jpwolfe9912/BareDrones-FC-V1/PNGs/3D Front.png

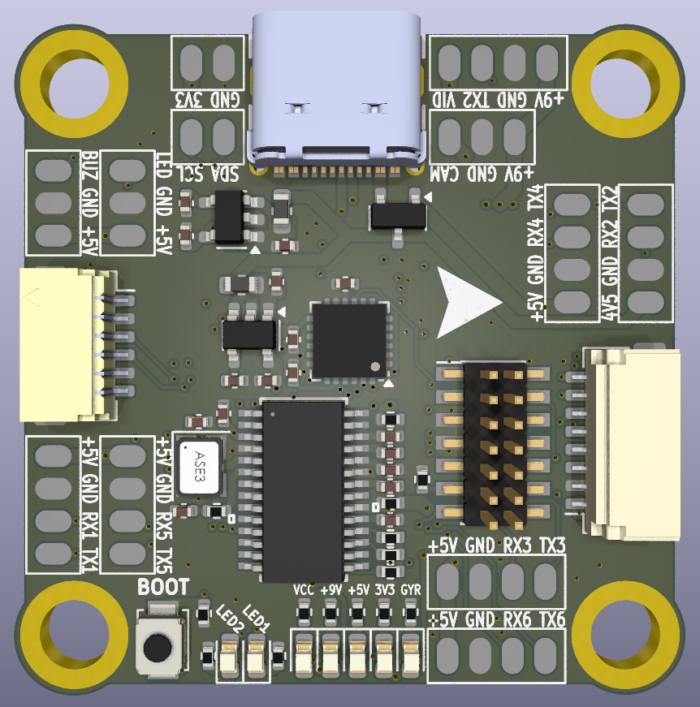
PNGs/3D Front.png
