jpwolfe9912/BareDrones-FC-V1/PNGs/3D Back.png

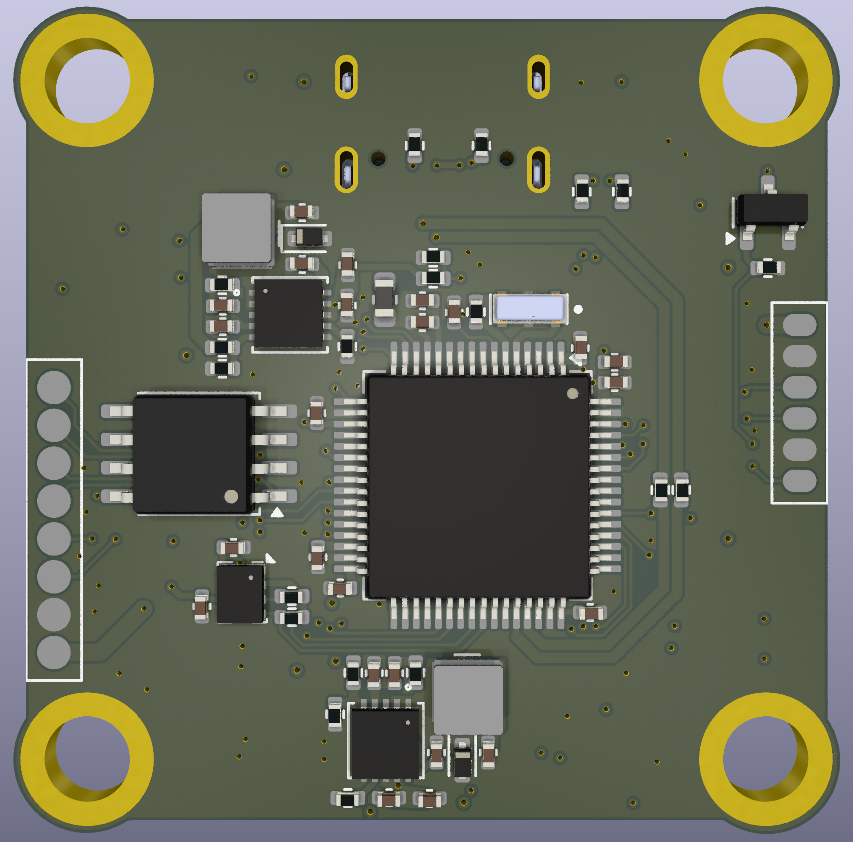
PNGs/3D Back.png
