jpwolfe9912/BareDrones-FC-V1/PNGs/Cu Pics/Back Cu.png

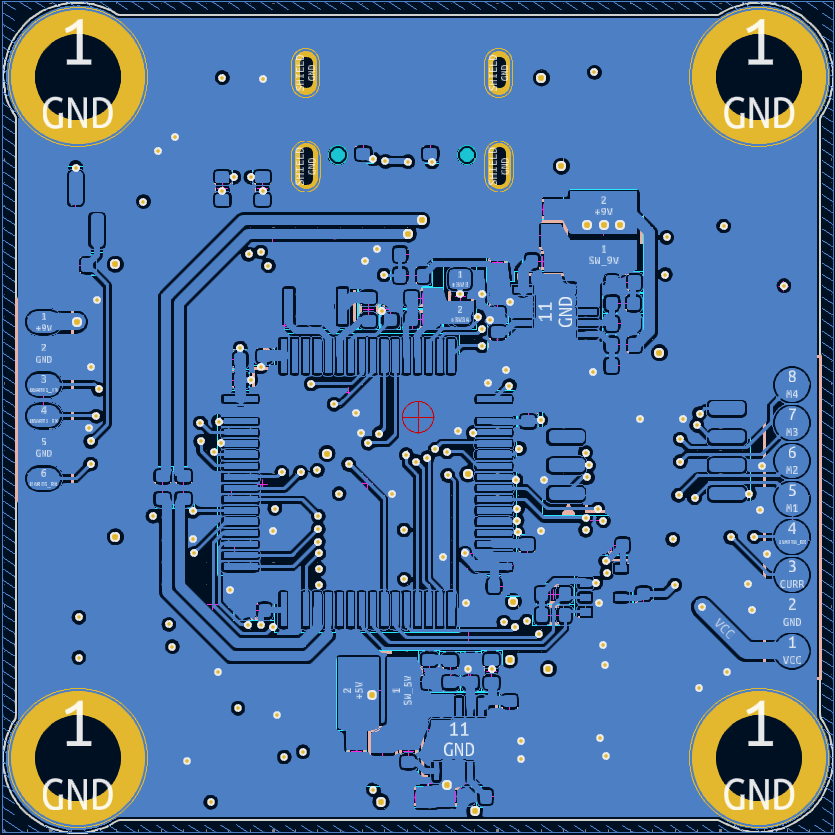
PNGs/Cu Pics/Back Cu.png
