jpwolfe9912/BareDrones-FC-V1/PNGs/Cu Pics/Front Cu.png

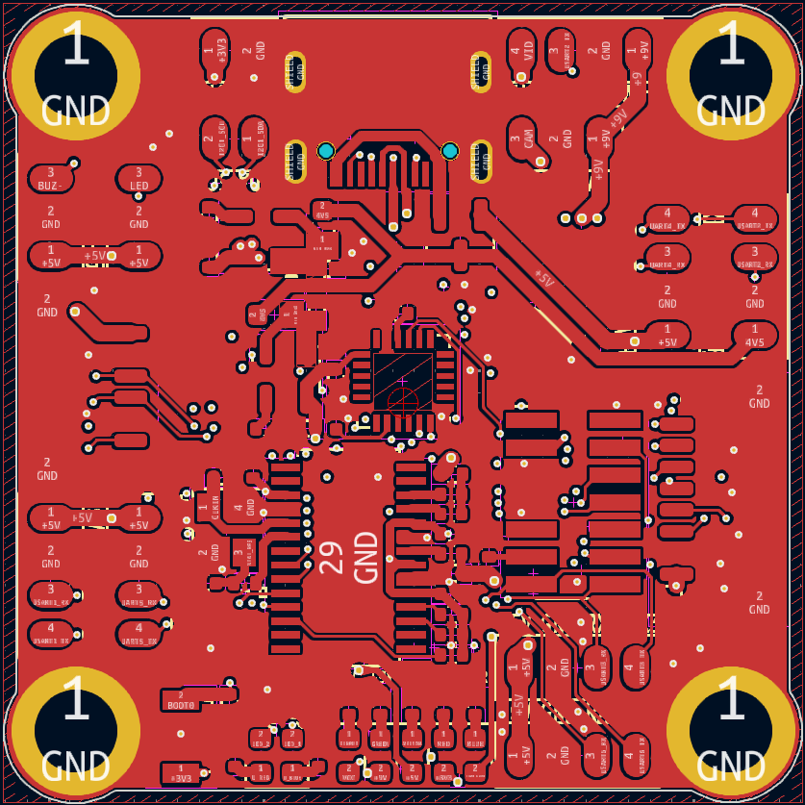
PNGs/Cu Pics/Front Cu.png
