jpwolfe9912/BareDrones-FC-V1/PNGs/Cu Pics/GND Cu.png

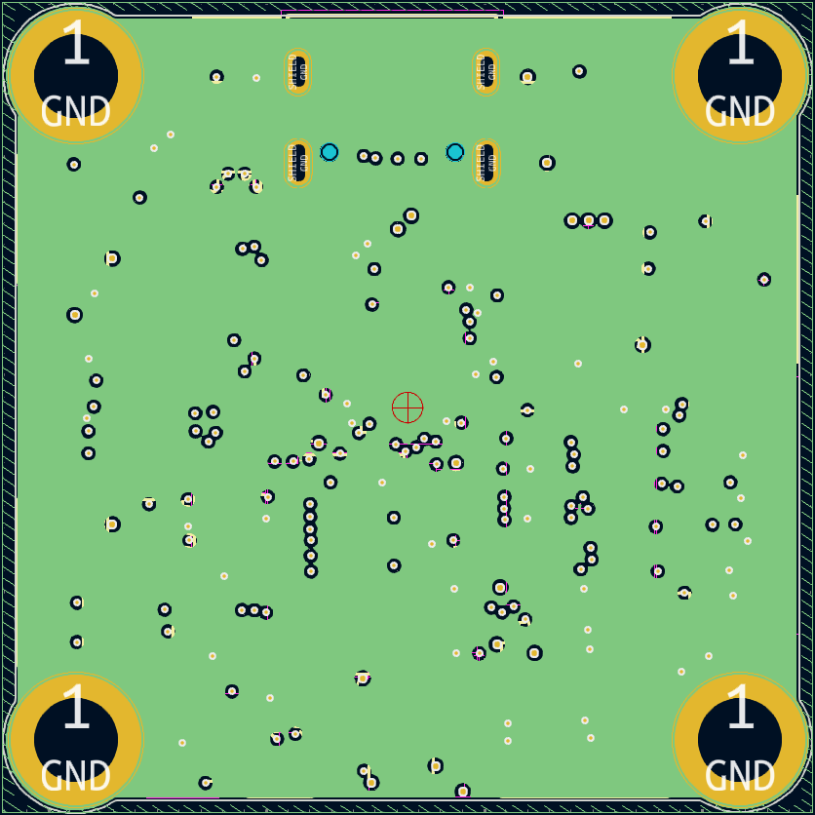
PNGs/Cu Pics/GND Cu.png
