jpwolfe9912/BareDrones-FC-V1/PNGs/Cu Pics/PWR Cu.png

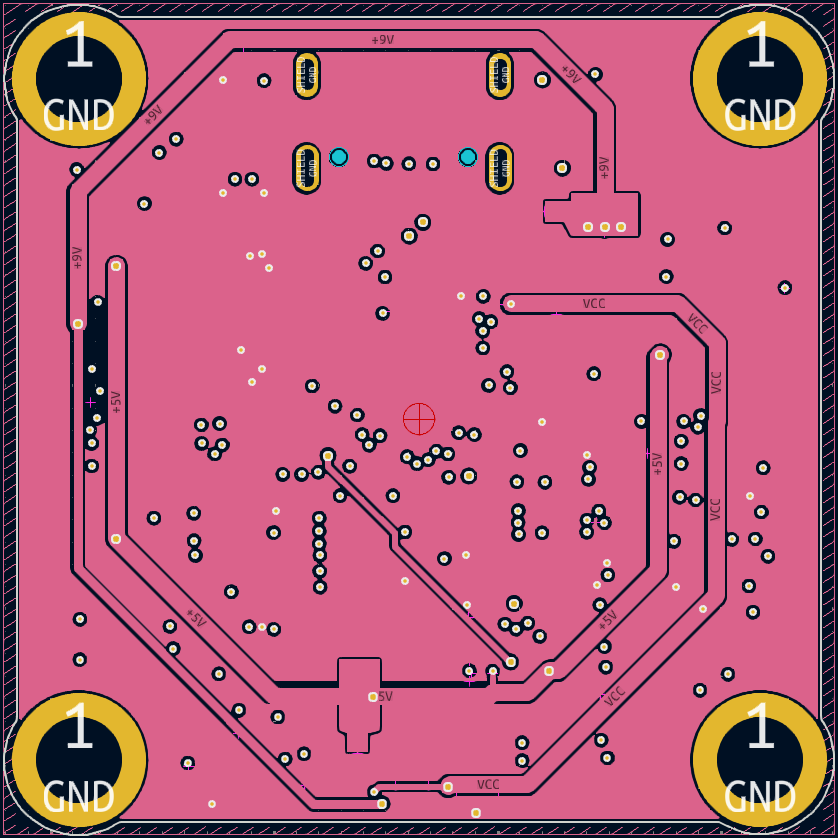
PNGs/Cu Pics/PWR Cu.png
