jpwolfe9912/BareDrones-FC-V1/PNGs/Cu Pics/Screenshot 2024-04-05 191036.png

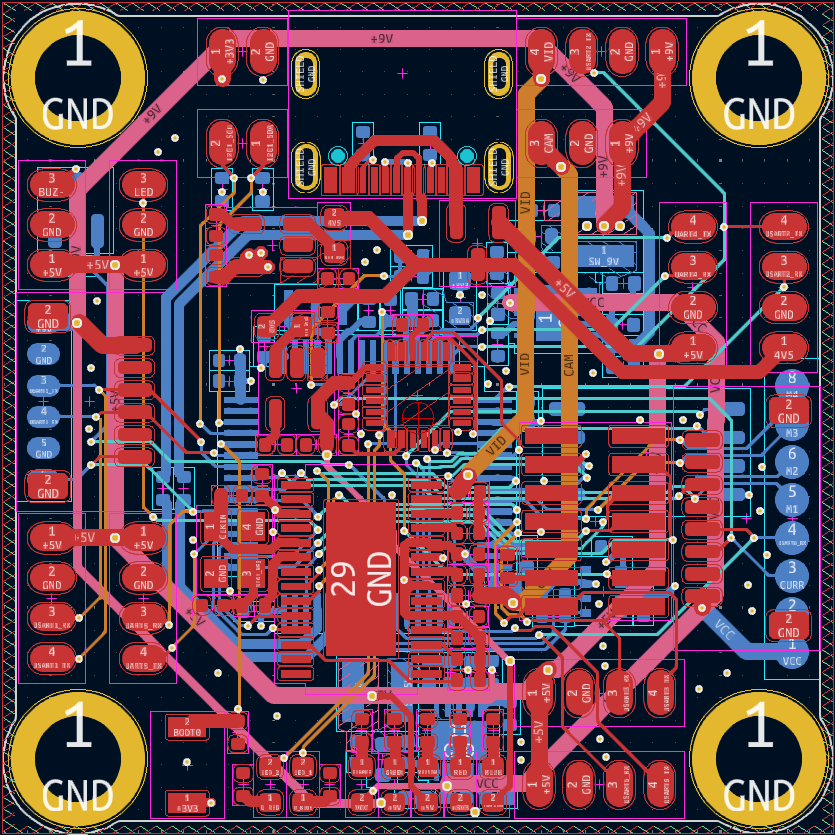
PNGs/Cu Pics/Screenshot 2024-04-05 191036.png
