jpwolfe9912/BareDrones-FC-V1/PNGs/Cu Pics/Signal 1 Cu.png

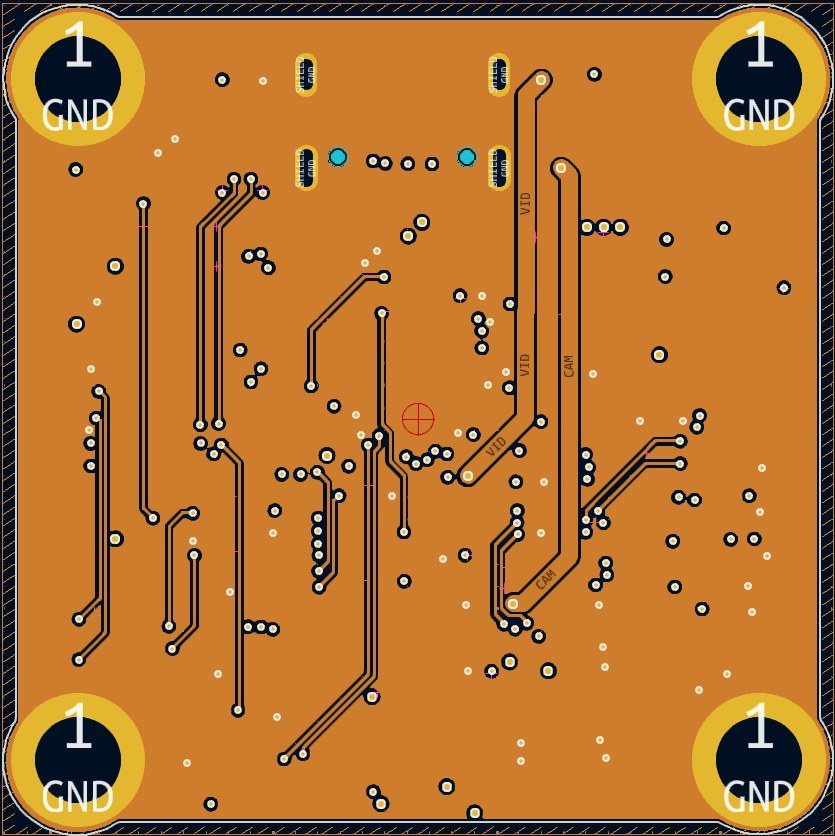
PNGs/Cu Pics/Signal 1 Cu.png
