jpwolfe9912/BareDrones-FC-V1/PNGs/Cu Pics/Signal 2 Cu.png

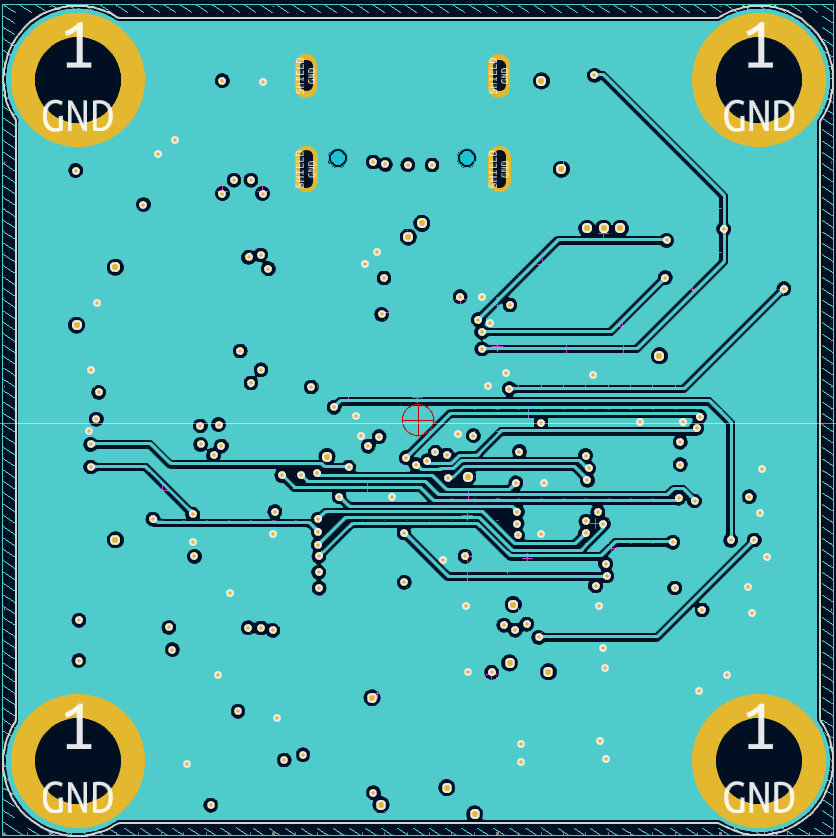
PNGs/Cu Pics/Signal 2 Cu.png
