jpwolfe9912/BareDrones-FC-V1/PNGs/Schematic.pdf

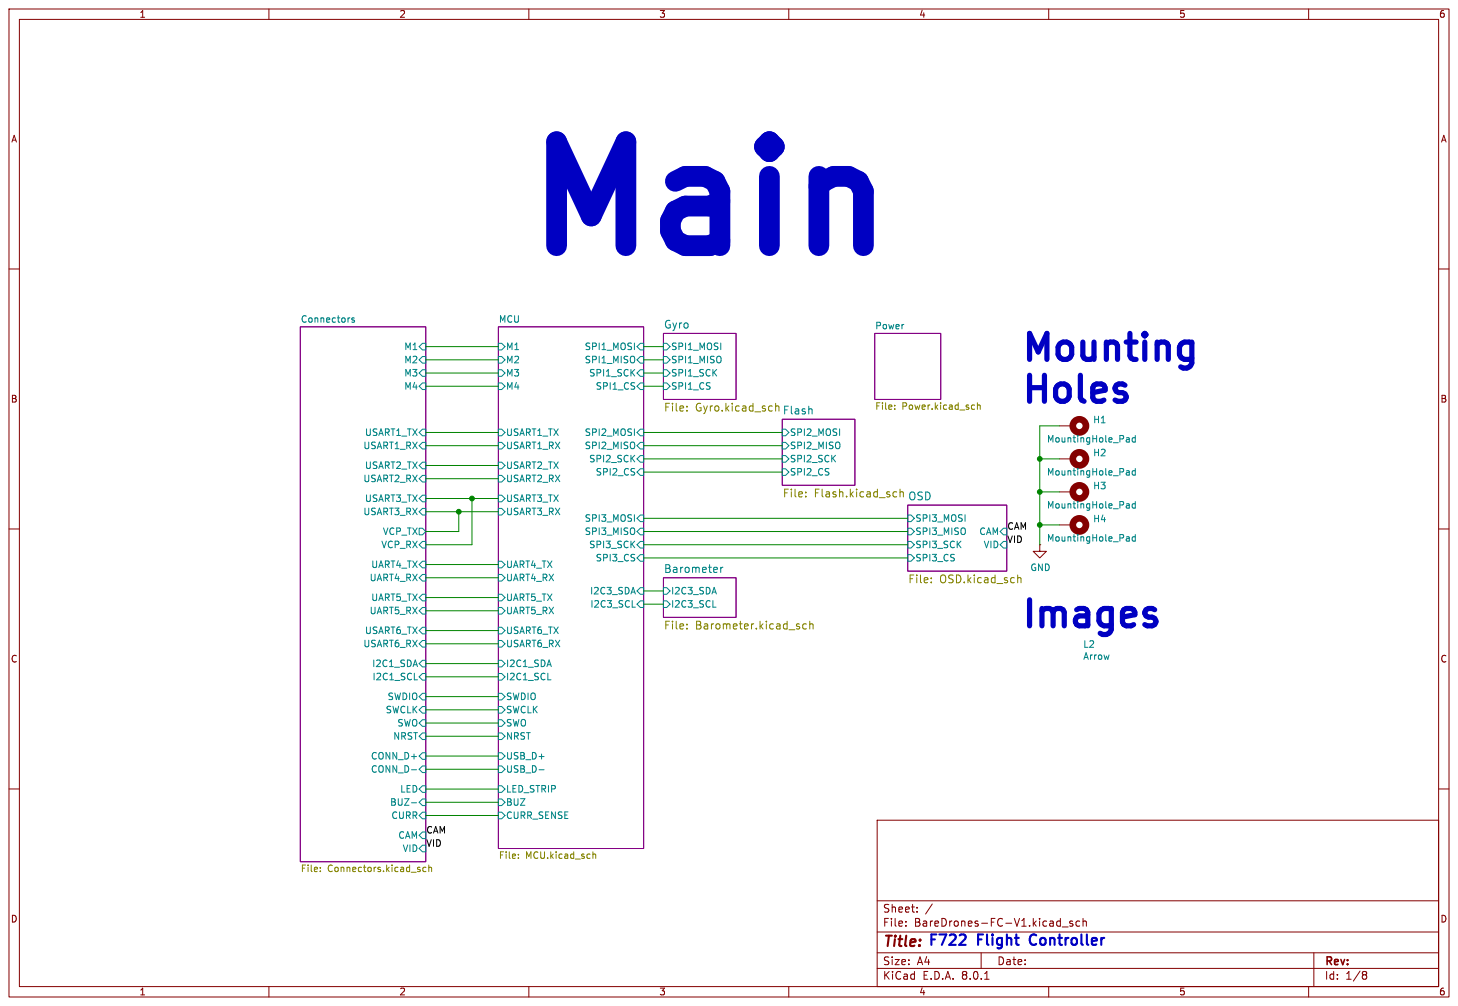
[picture p11: page 1]

SPI1_CS Gyro File: Gyro.kicad_sch
File: OSD.kicad_sch Power File: Power.kicad_sch SPI1_MOSI SPI1_MISO

Id: 1/8 Title: File: BareDrones-FC-V1.kicad_sch Sheet: /
F722 Flight Controller

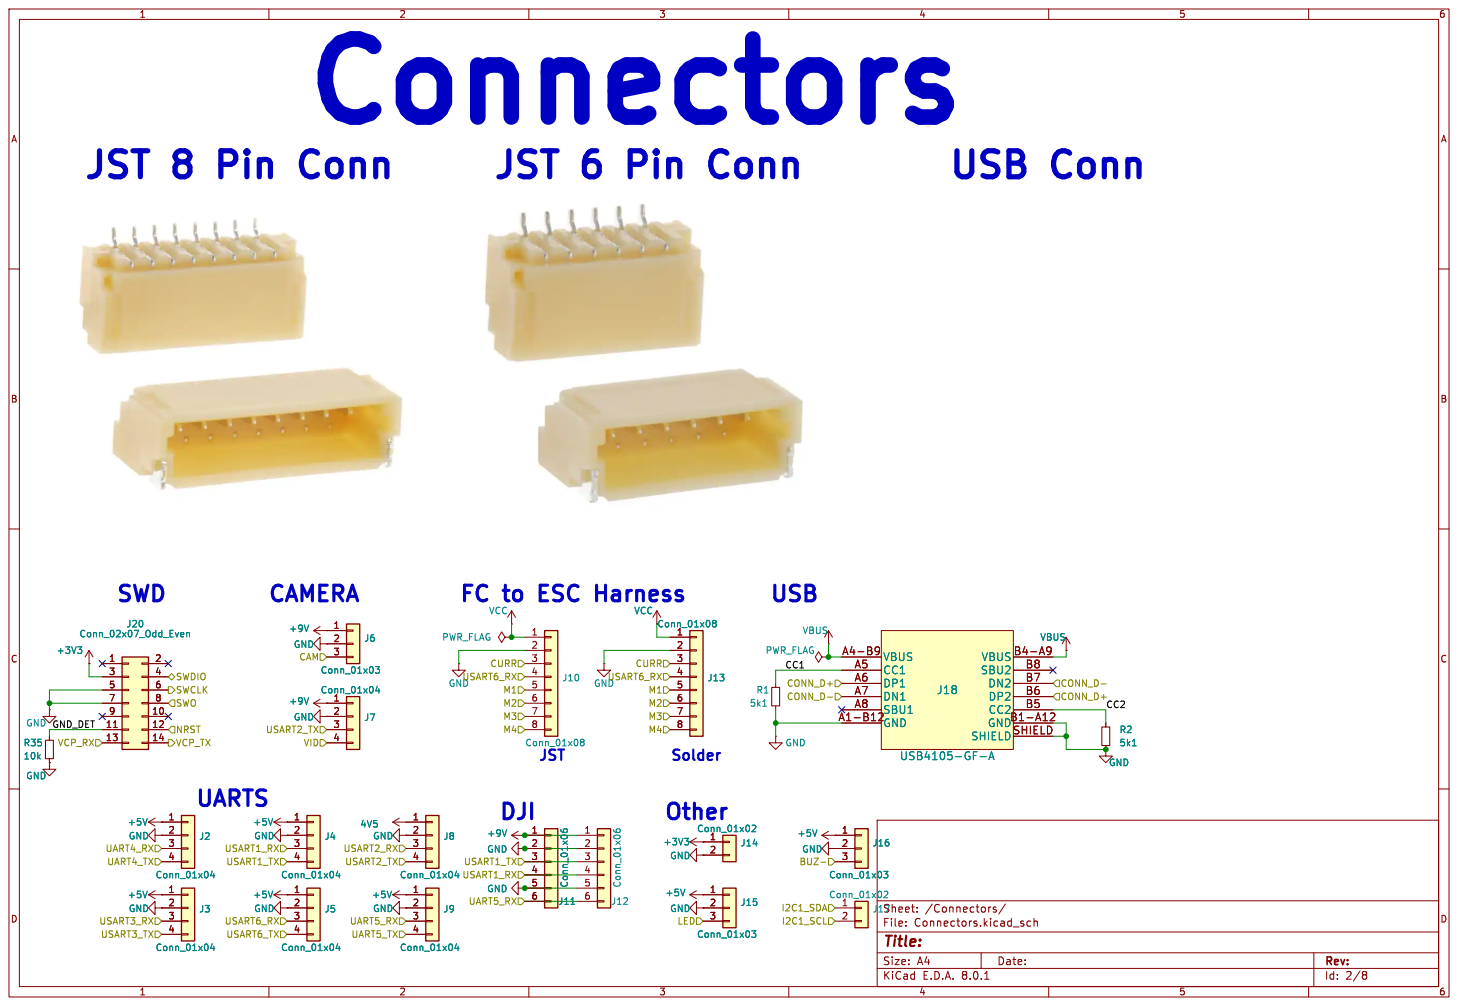
[picture p12: page 2]

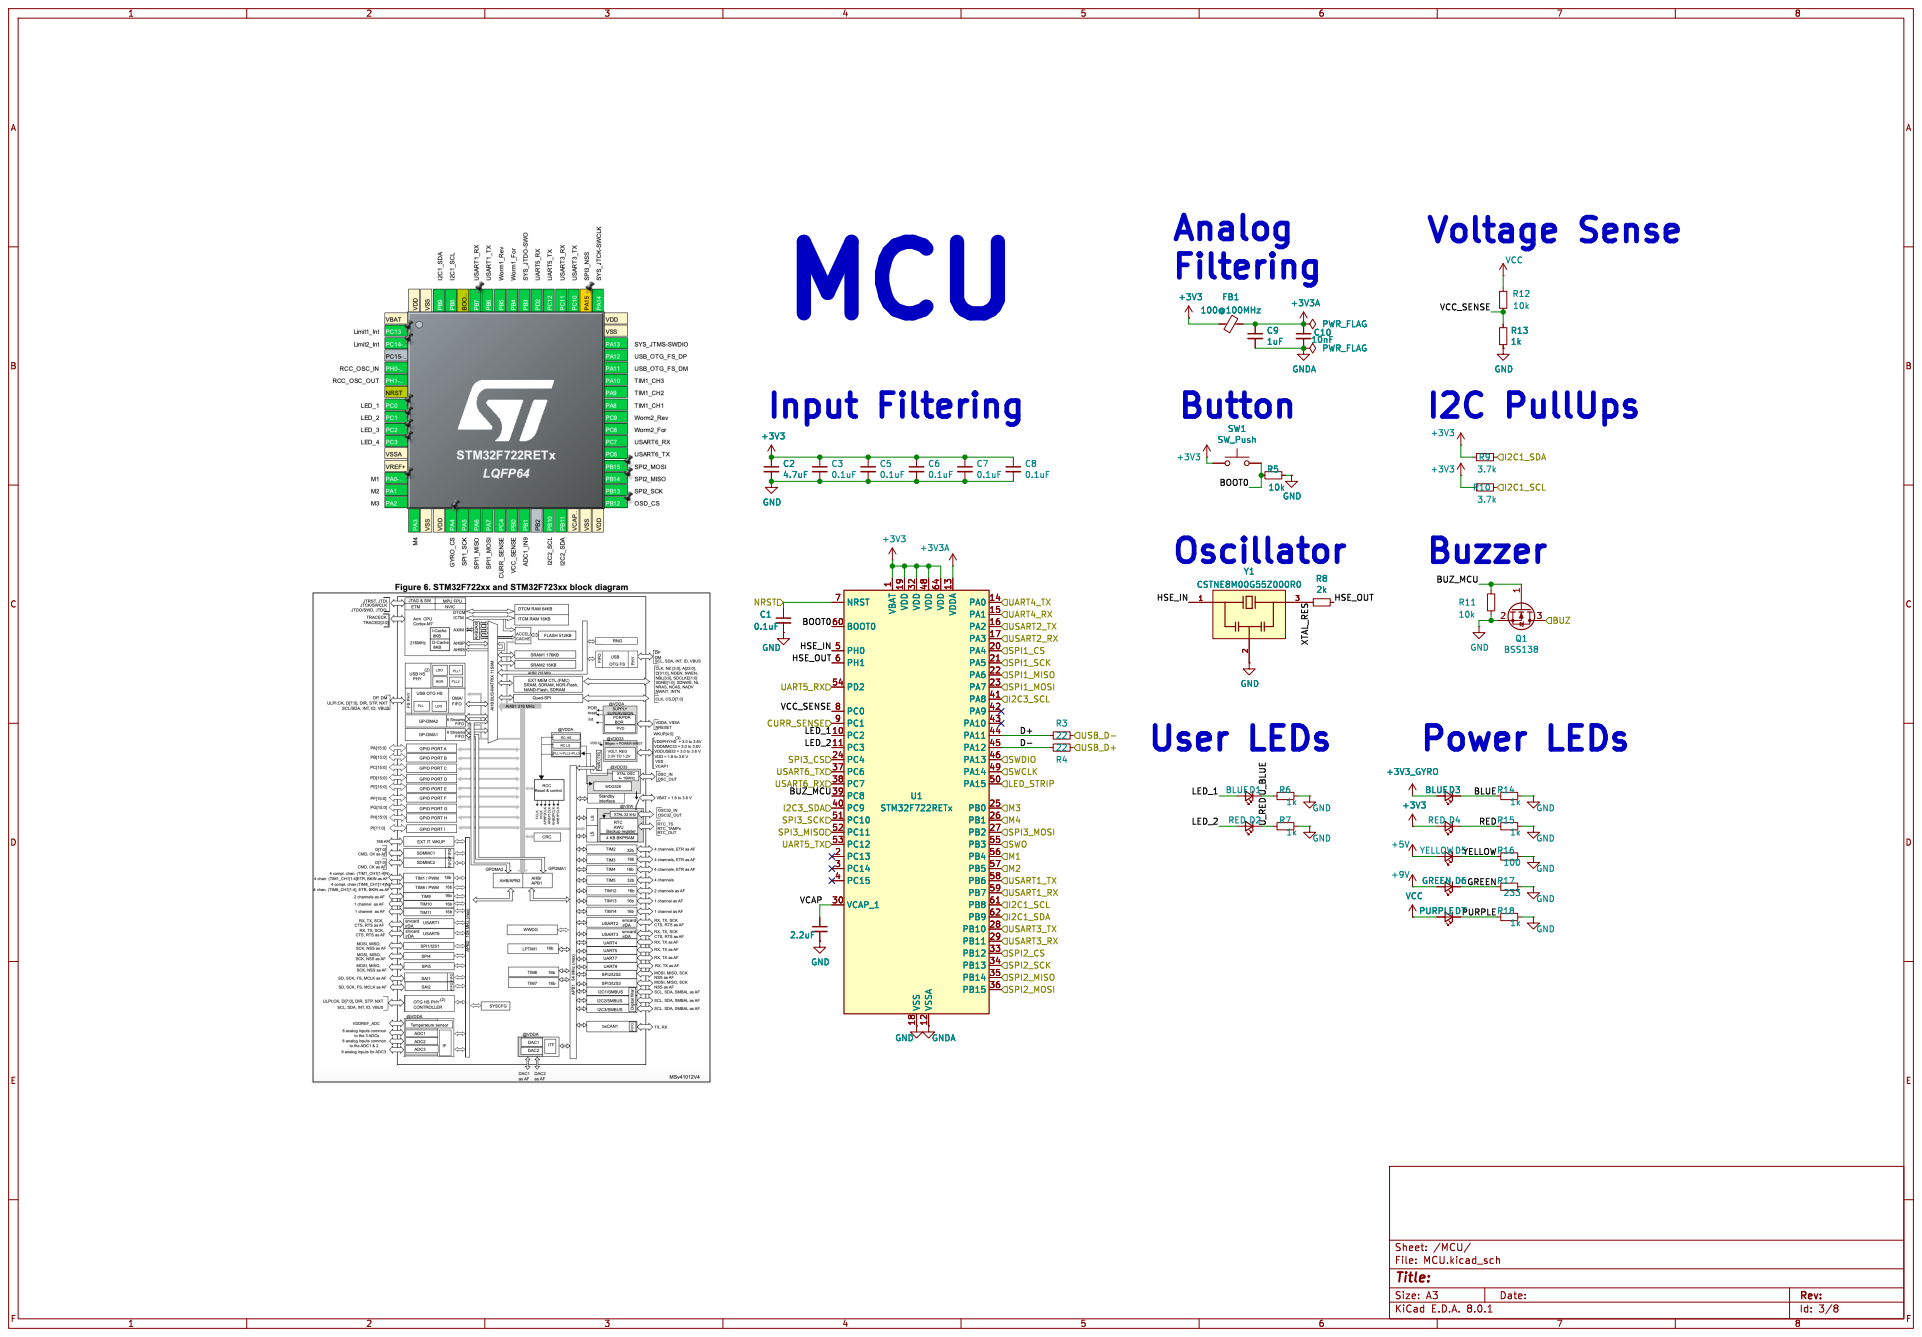
[picture p13: page 3]

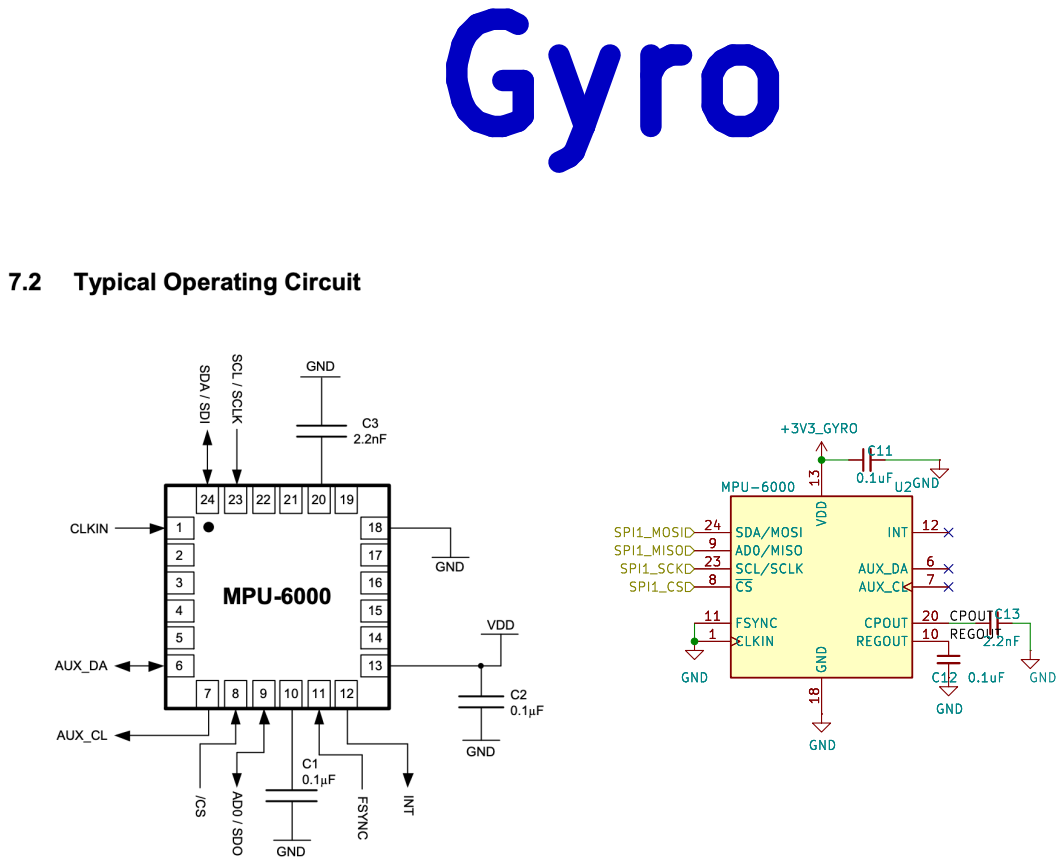
[picture p14: page 4]

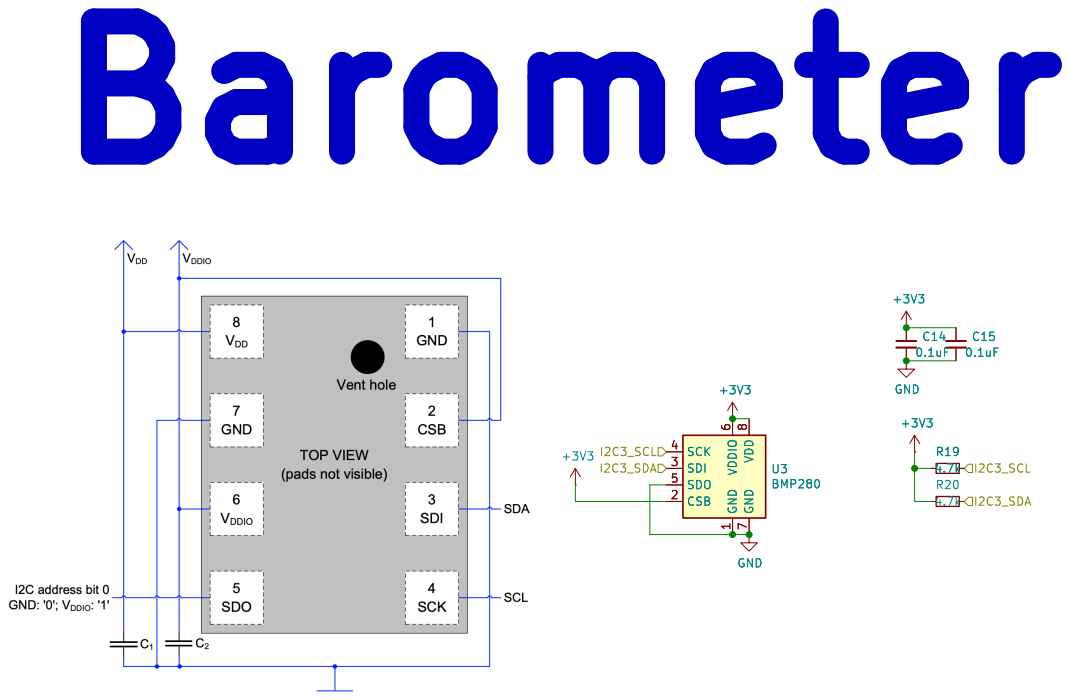
[picture p15: page 5]

1 CSB 2 SDI 3 SCK 4 SDO 5 VDDIO

Id: 5/8 Title: File: Barometer.kicad_sch Sheet: /Barometer/ GND

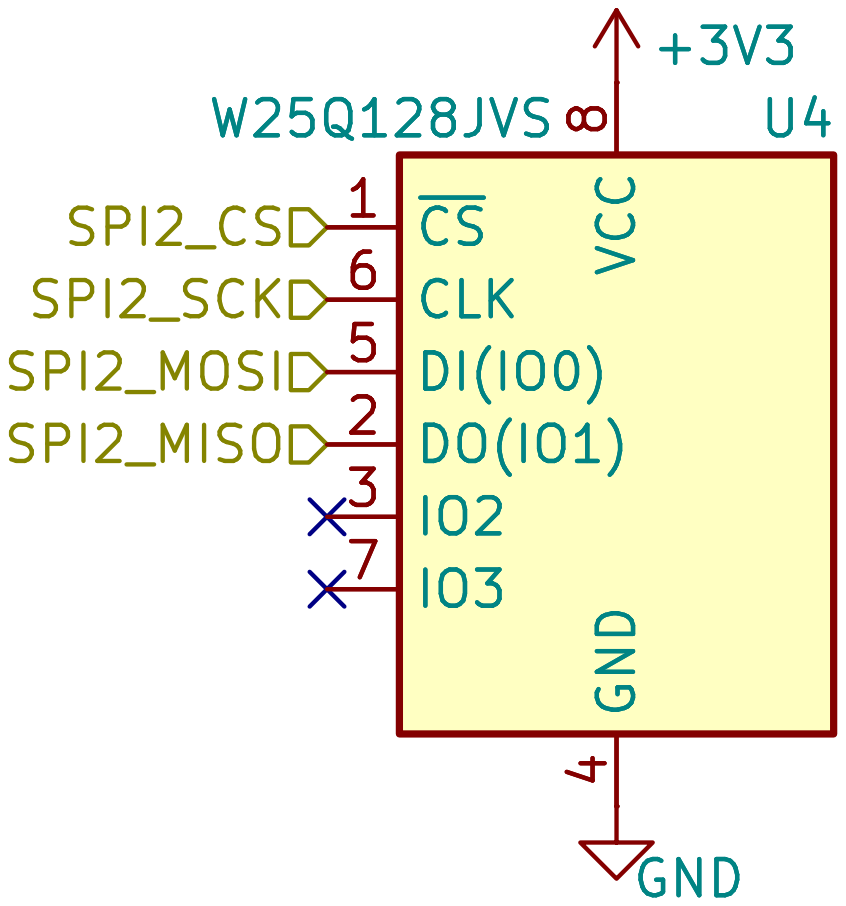
[picture p16: page 6]

Id: 6/8 Title: File: Flash.kicad_sch Sheet: /Flash/ GND

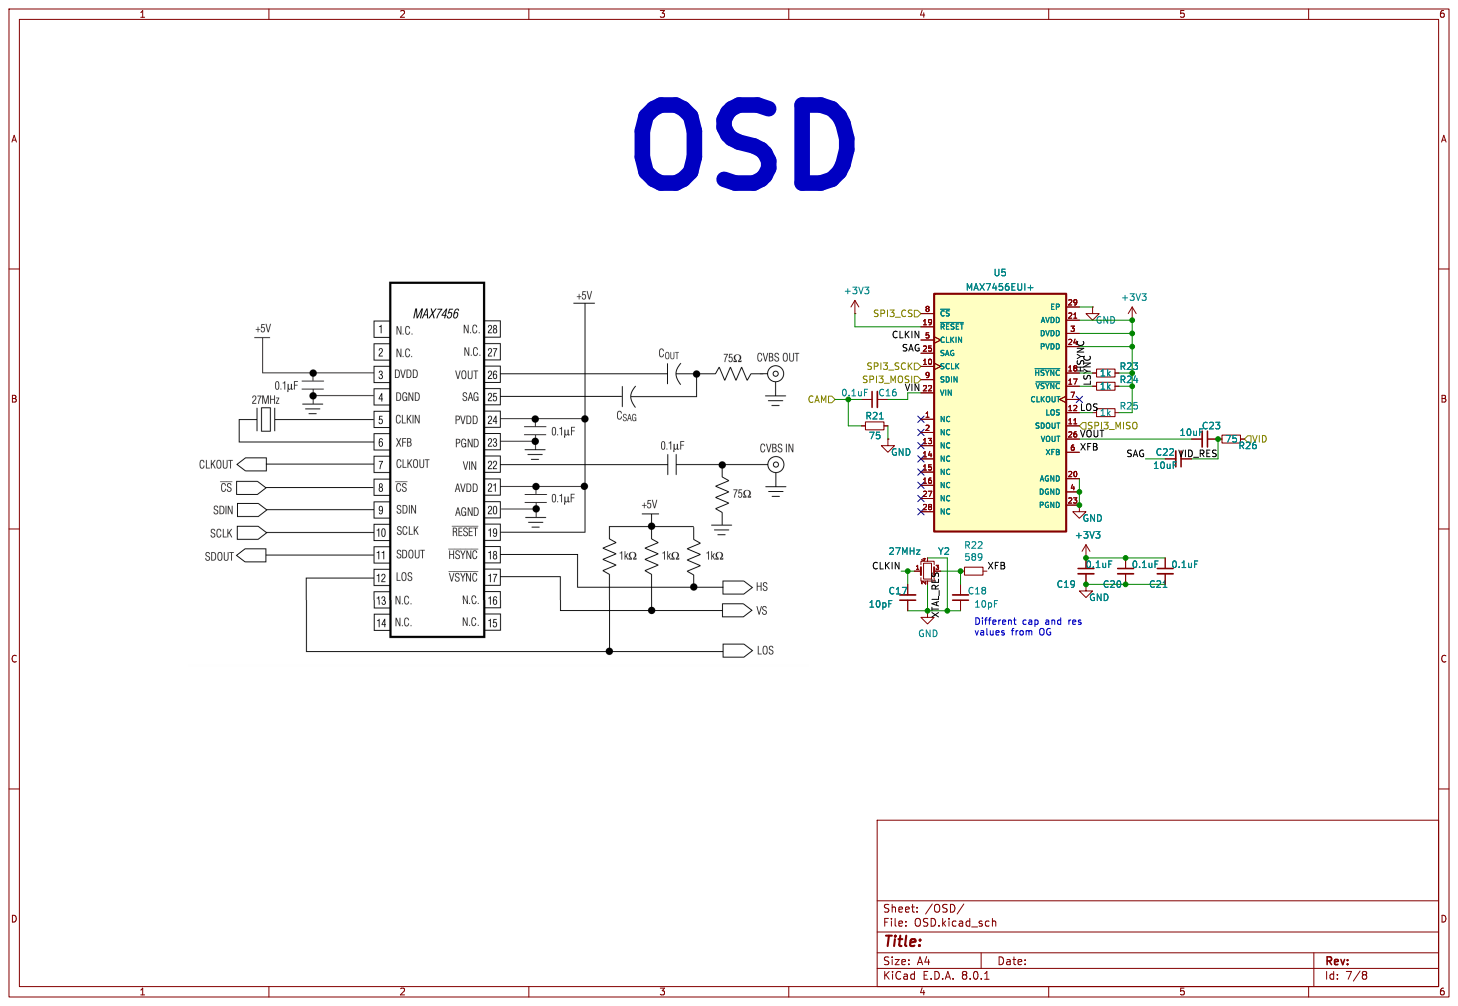
[picture p17: page 7]

values from OG OSD

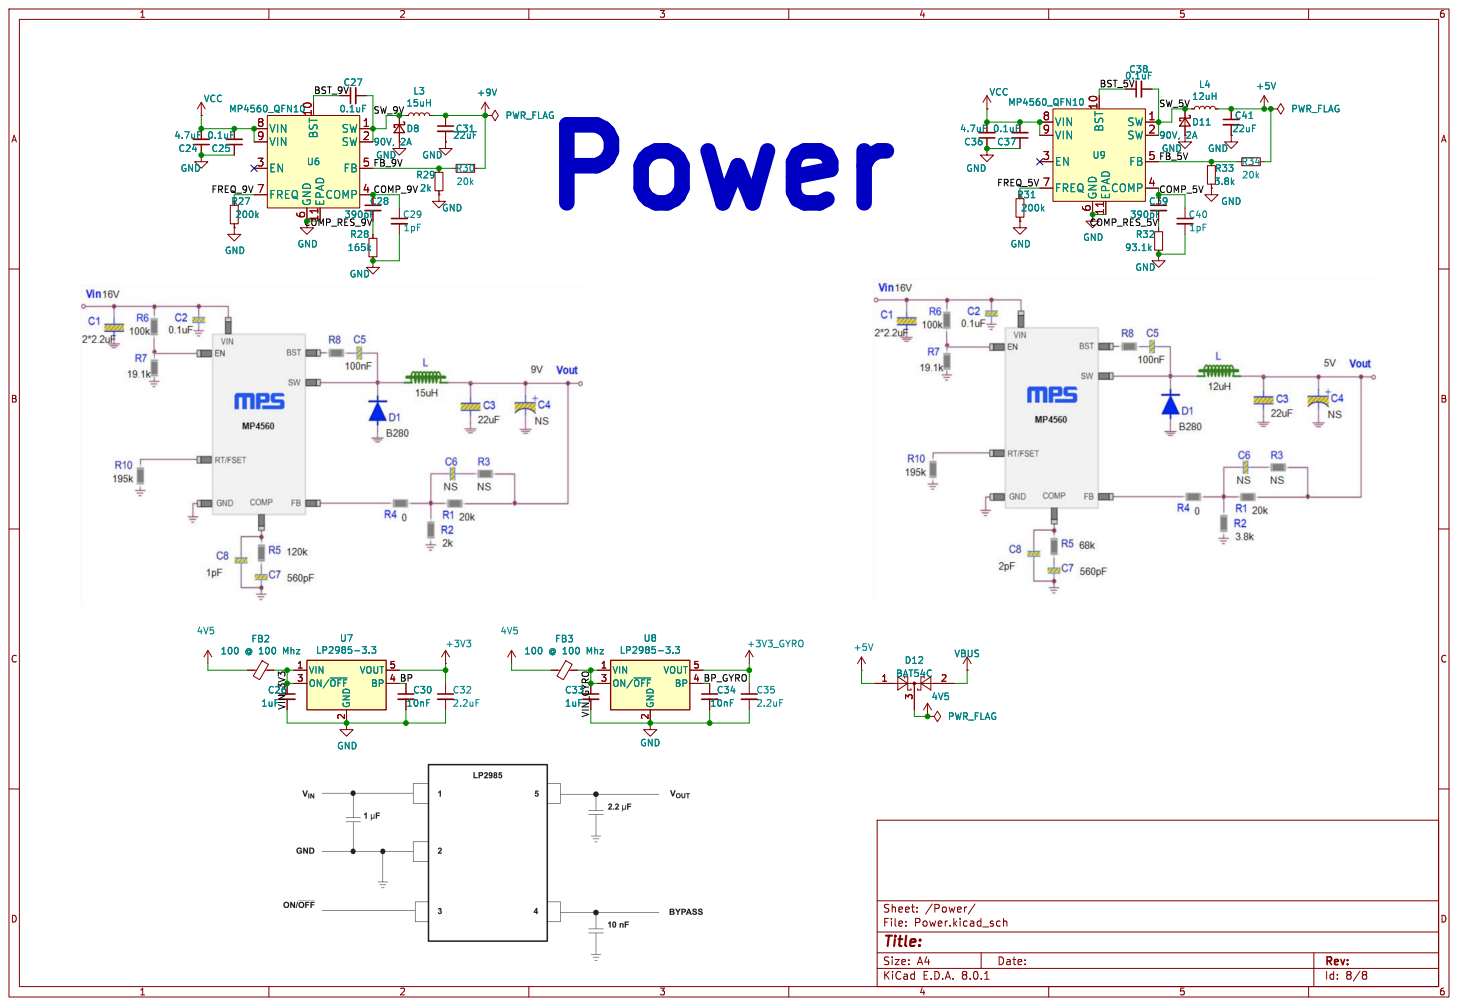
[picture p18: page 8]

2 ON/~{OFF} 3 BP 4 VOUT 5 U7

2 ON/~{OFF} 3 BP 4 VOUT 5 FB3

2 ON/~{OFF} 3 BP 4 VOUT 5 U8

2 ON/~{OFF} 3 BP 4 VOUT 5 C26
