jpwolfe9912/BareDrones-FC-V1/Gerbers/BareDrones-FC-V1-B_Silkscreen.pdf

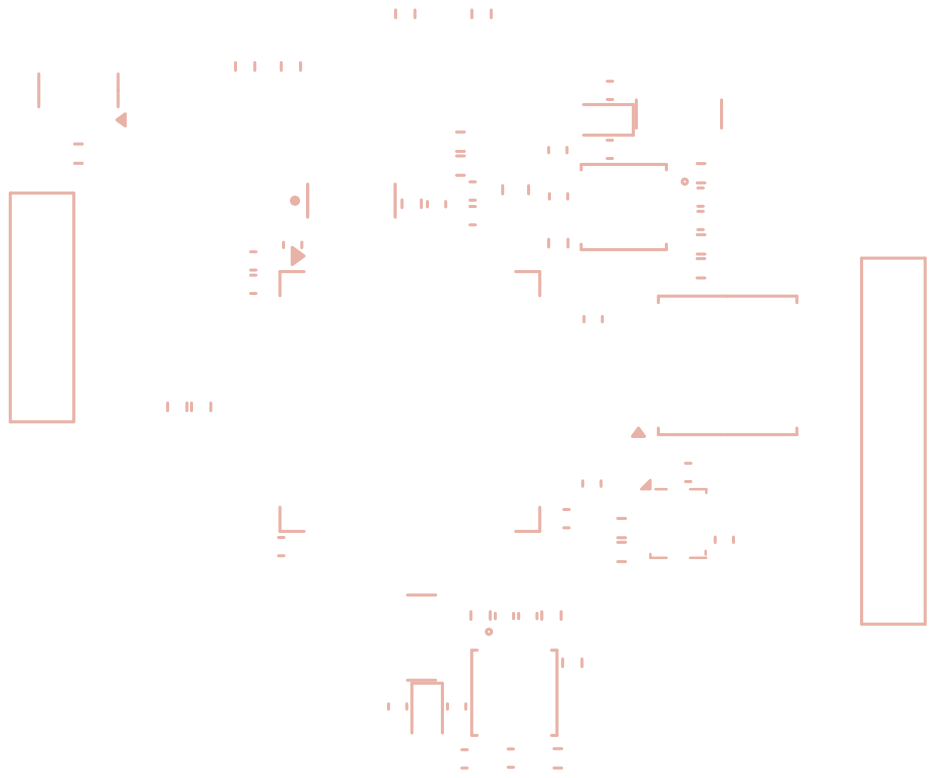
[picture p20: page 1]

Id: 1/1 Title: File: BareDrones-FC-V1.kicad_pcb Sheet:
