jpwolfe9912/BareDrones-FC-V1/Gerbers/BareDrones-FC-V1-F_Mask.pdf

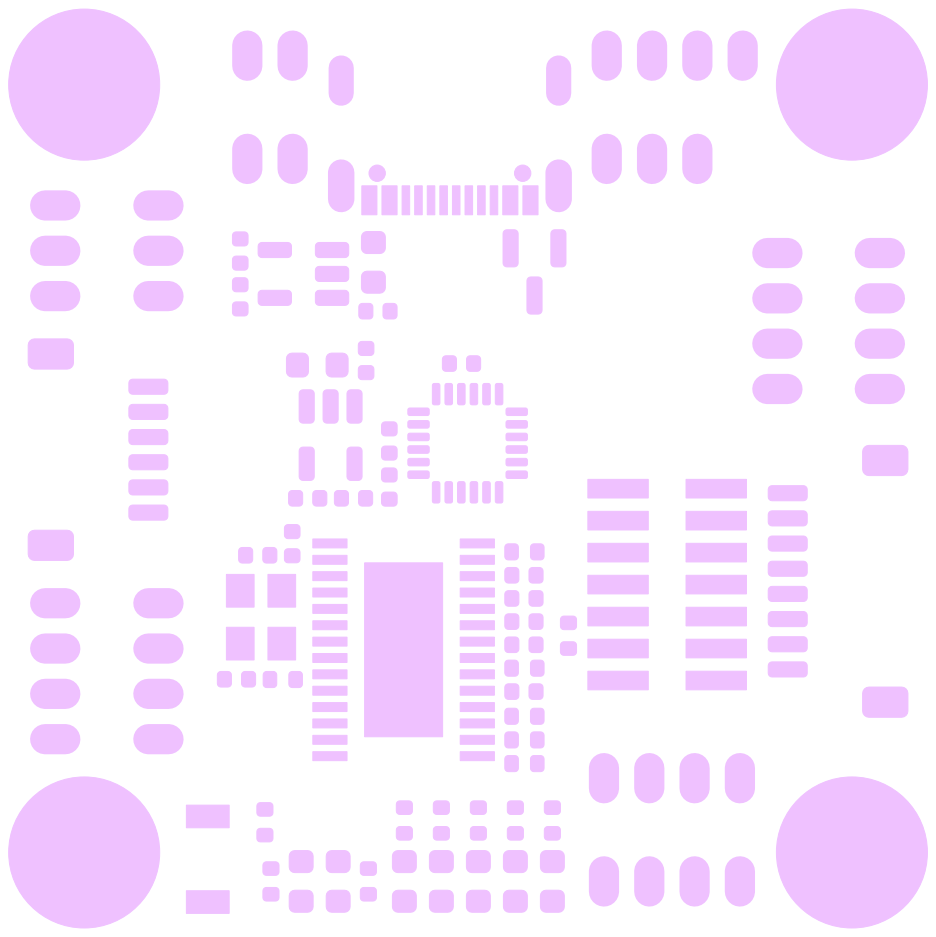
[picture p22: page 1]

Id: 1/1 Title: File: BareDrones-FC-V1.kicad_pcb Sheet:
