jpwolfe9912/BareDrones-FC-V1/Gerbers/BareDrones-FC-V1-F_Silkscreen.pdf

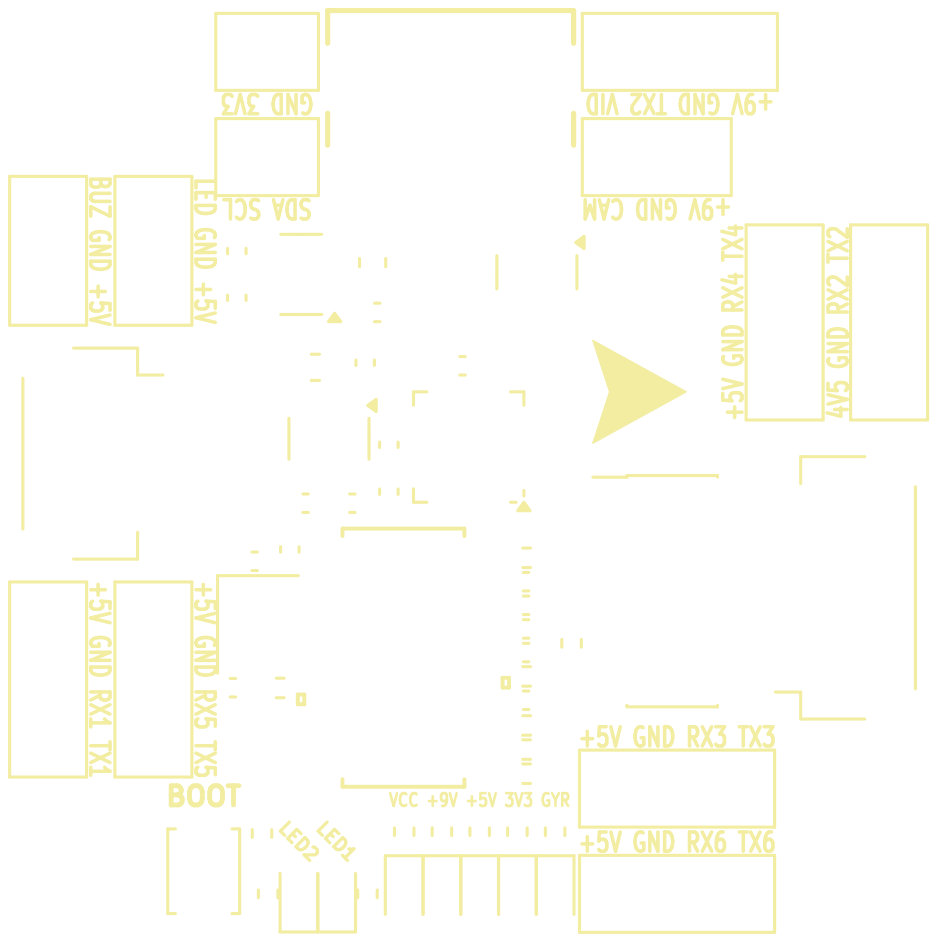
[picture p23: page 1]

LED1VCC +9V +5V 3V3 GYR +5V GND RX5 TX5 CAM GND +9V

Id: 1/1 Title: File: BareDrones-FC-V1.kicad_pcb Sheet: +5V GND RX1 TX1
