jpwolfe9912/BareDrones-FC-V1/Gerbers/BareDrones-FC-V1-GND.pdf

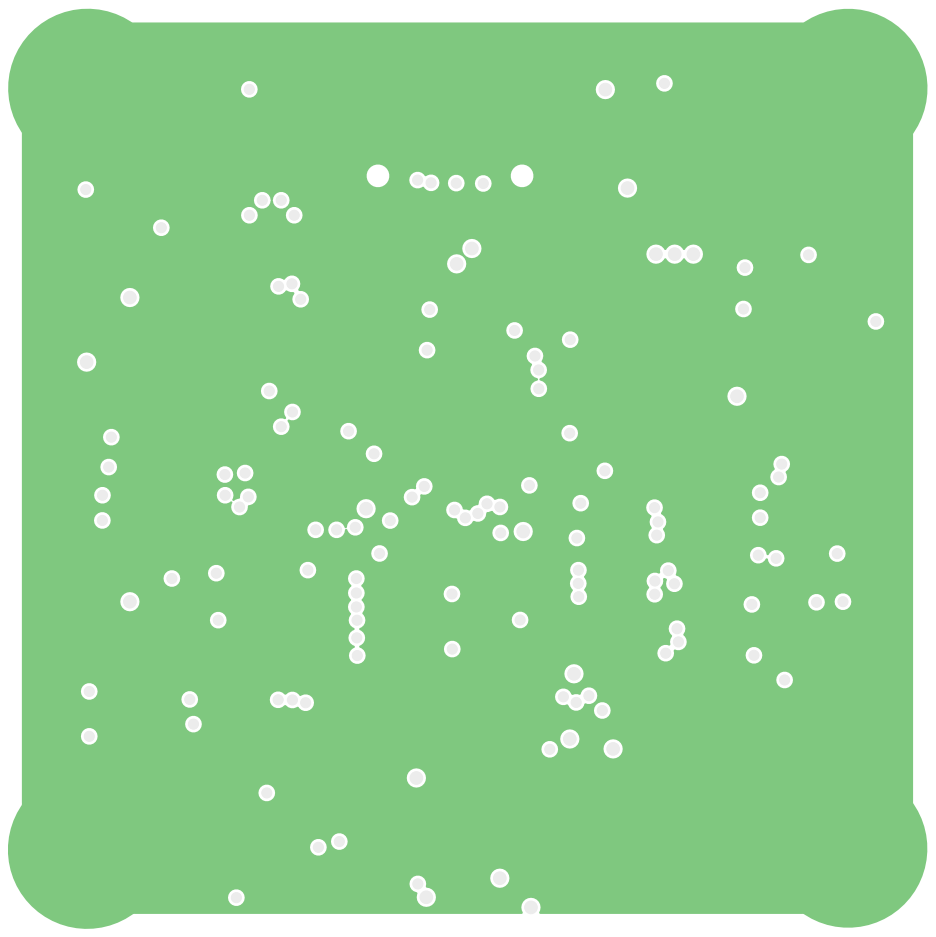
[picture p24: page 1]

Id: 1/1 Title: File: BareDrones-FC-V1.kicad_pcb Sheet:
