jpwolfe9912/BareDrones-FC-V1/Gerbers/BareDrones-FC-V1-PWR.pdf

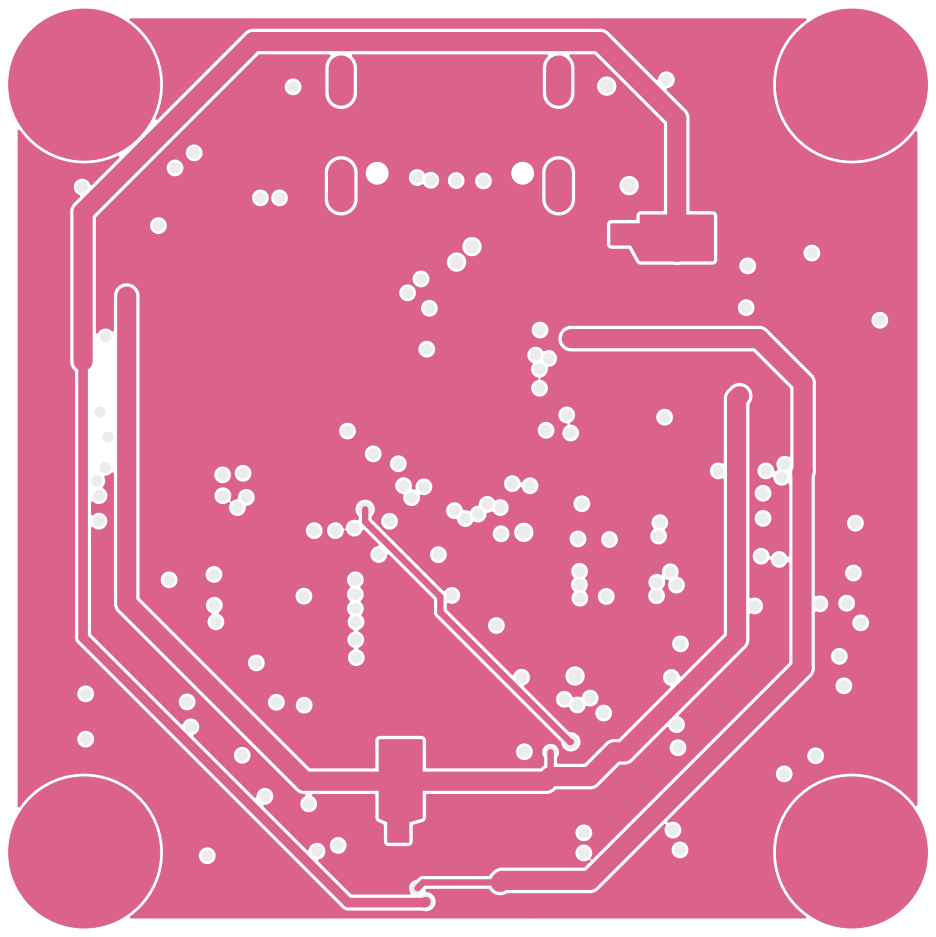
[picture p25: page 1]

Id: 1/1 Title: File: BareDrones-FC-V1.kicad_pcb Sheet:
