jpwolfe9912/BareDrones-FC-V1/PNGs/Gerber PDFs.pdf

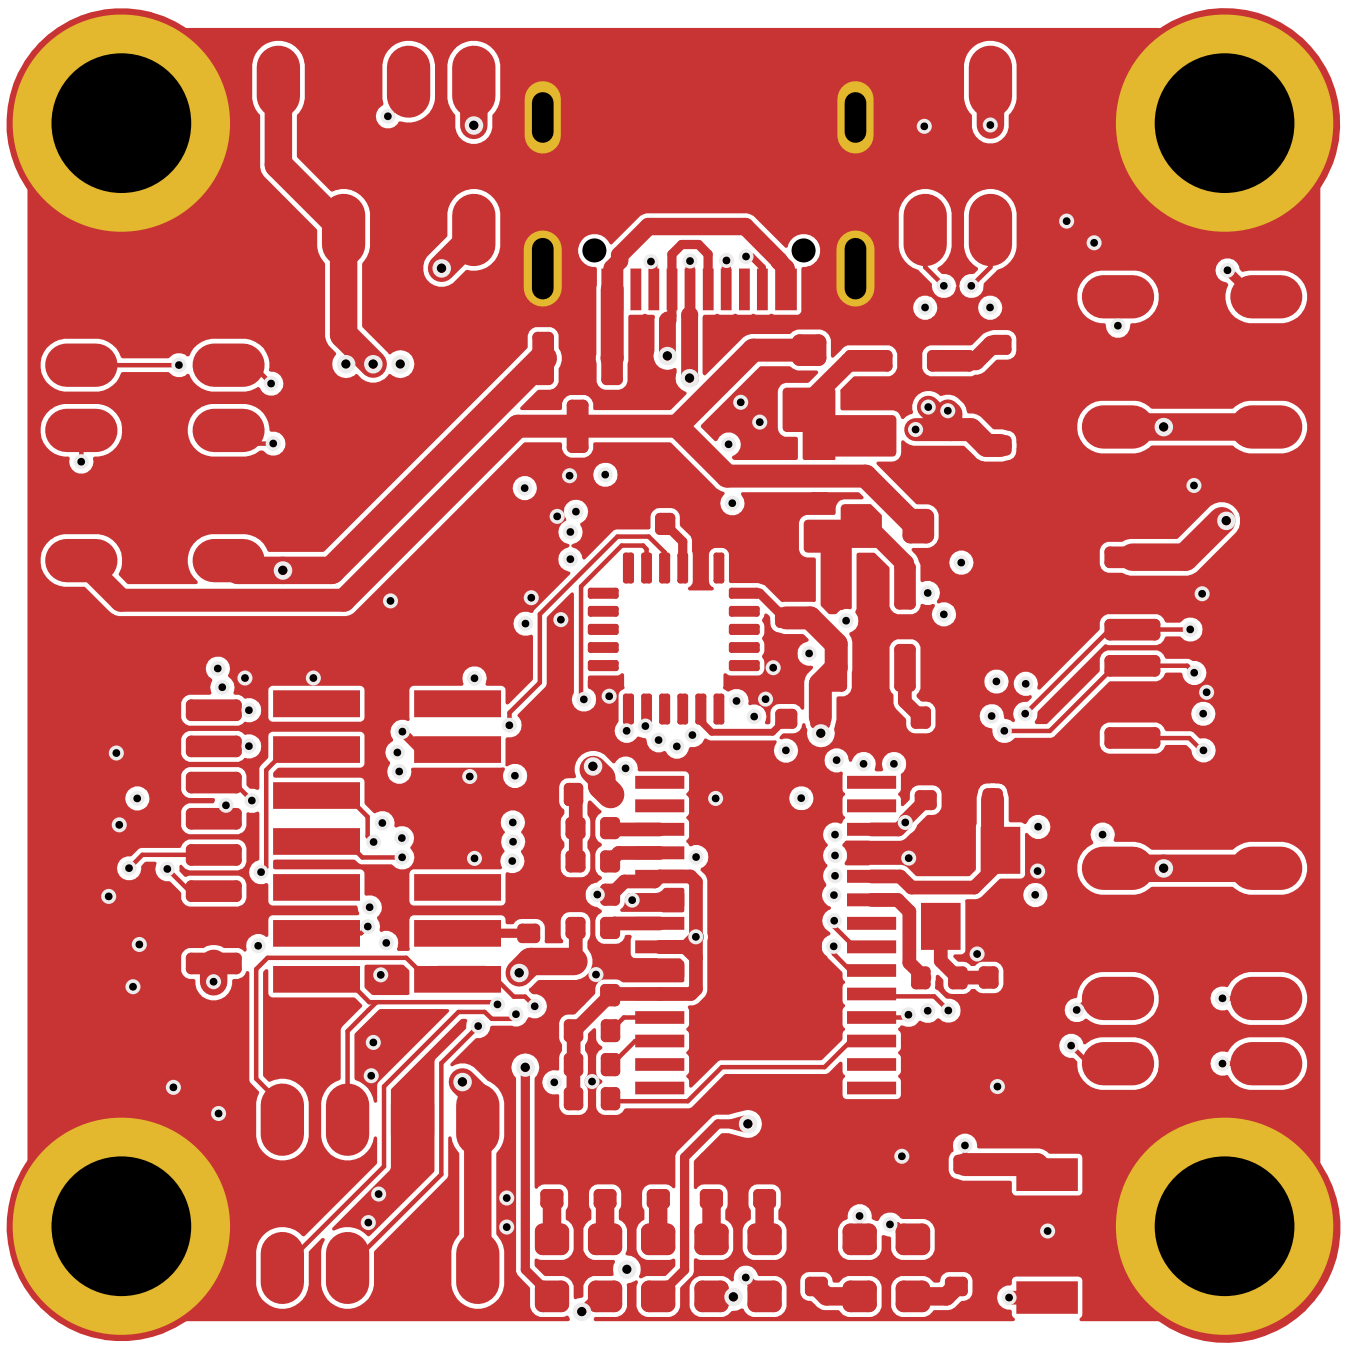
[picture p30: page 1]

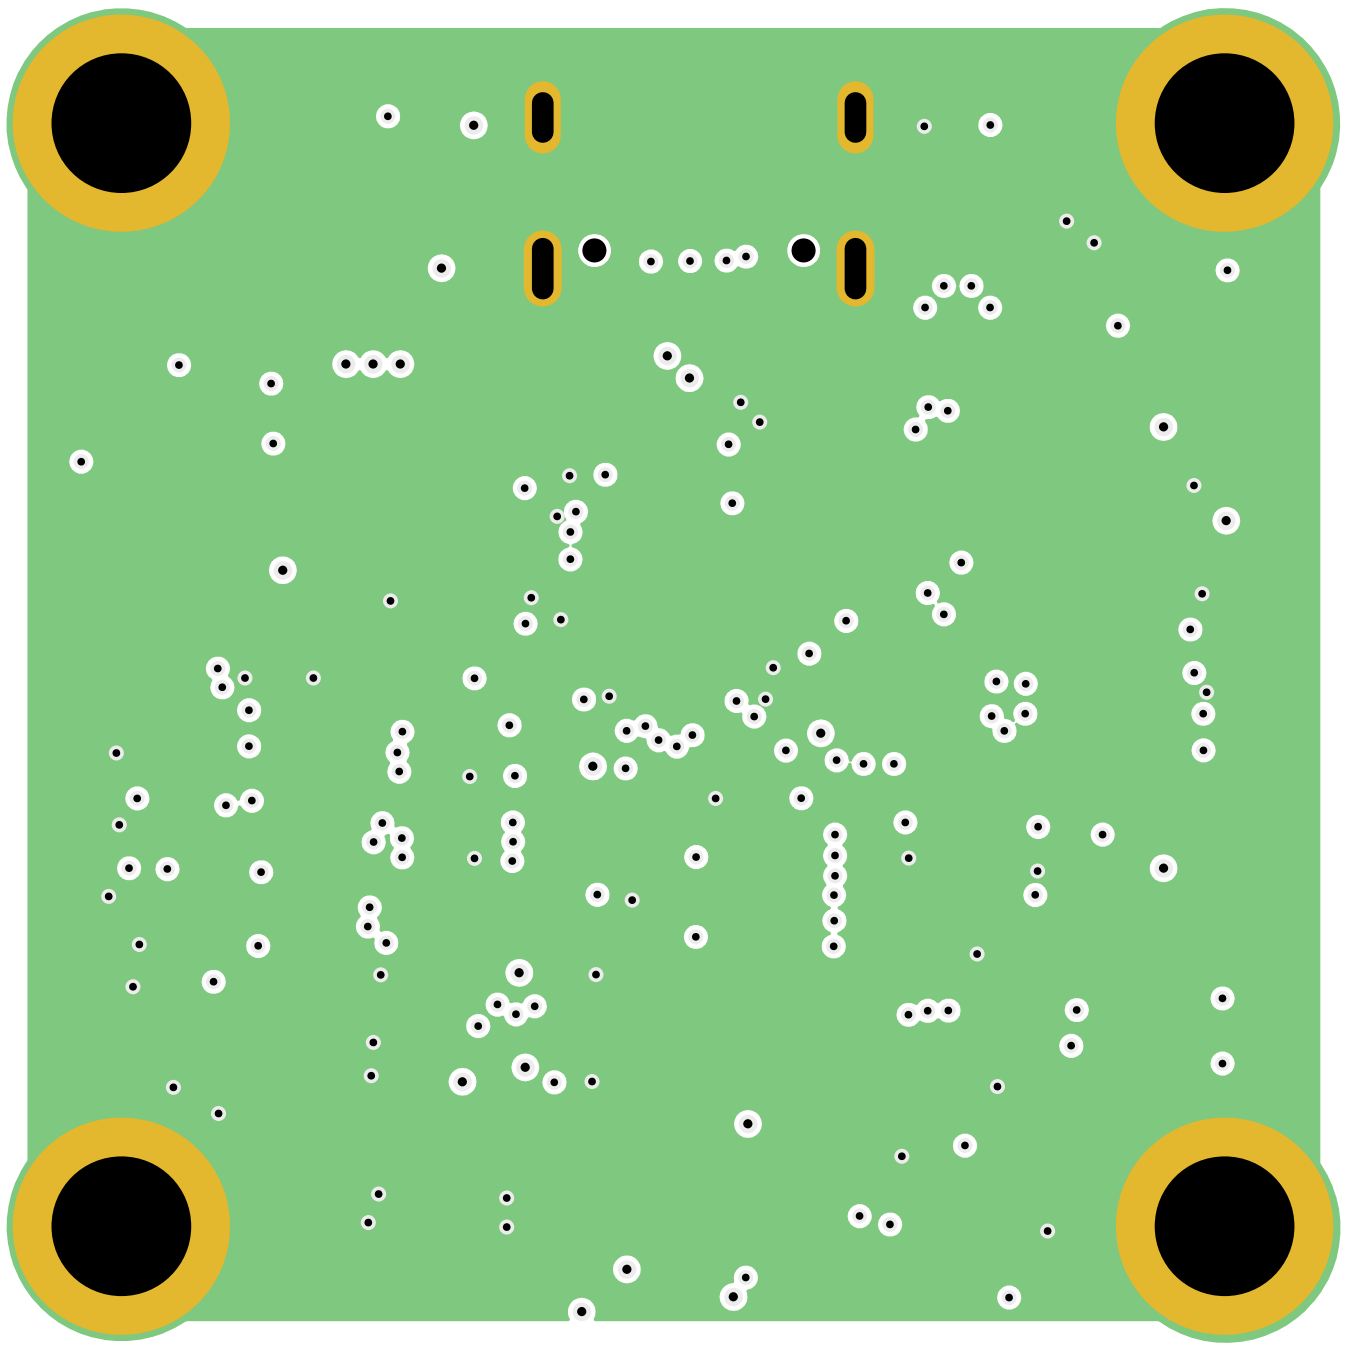
[picture p31: page 2]

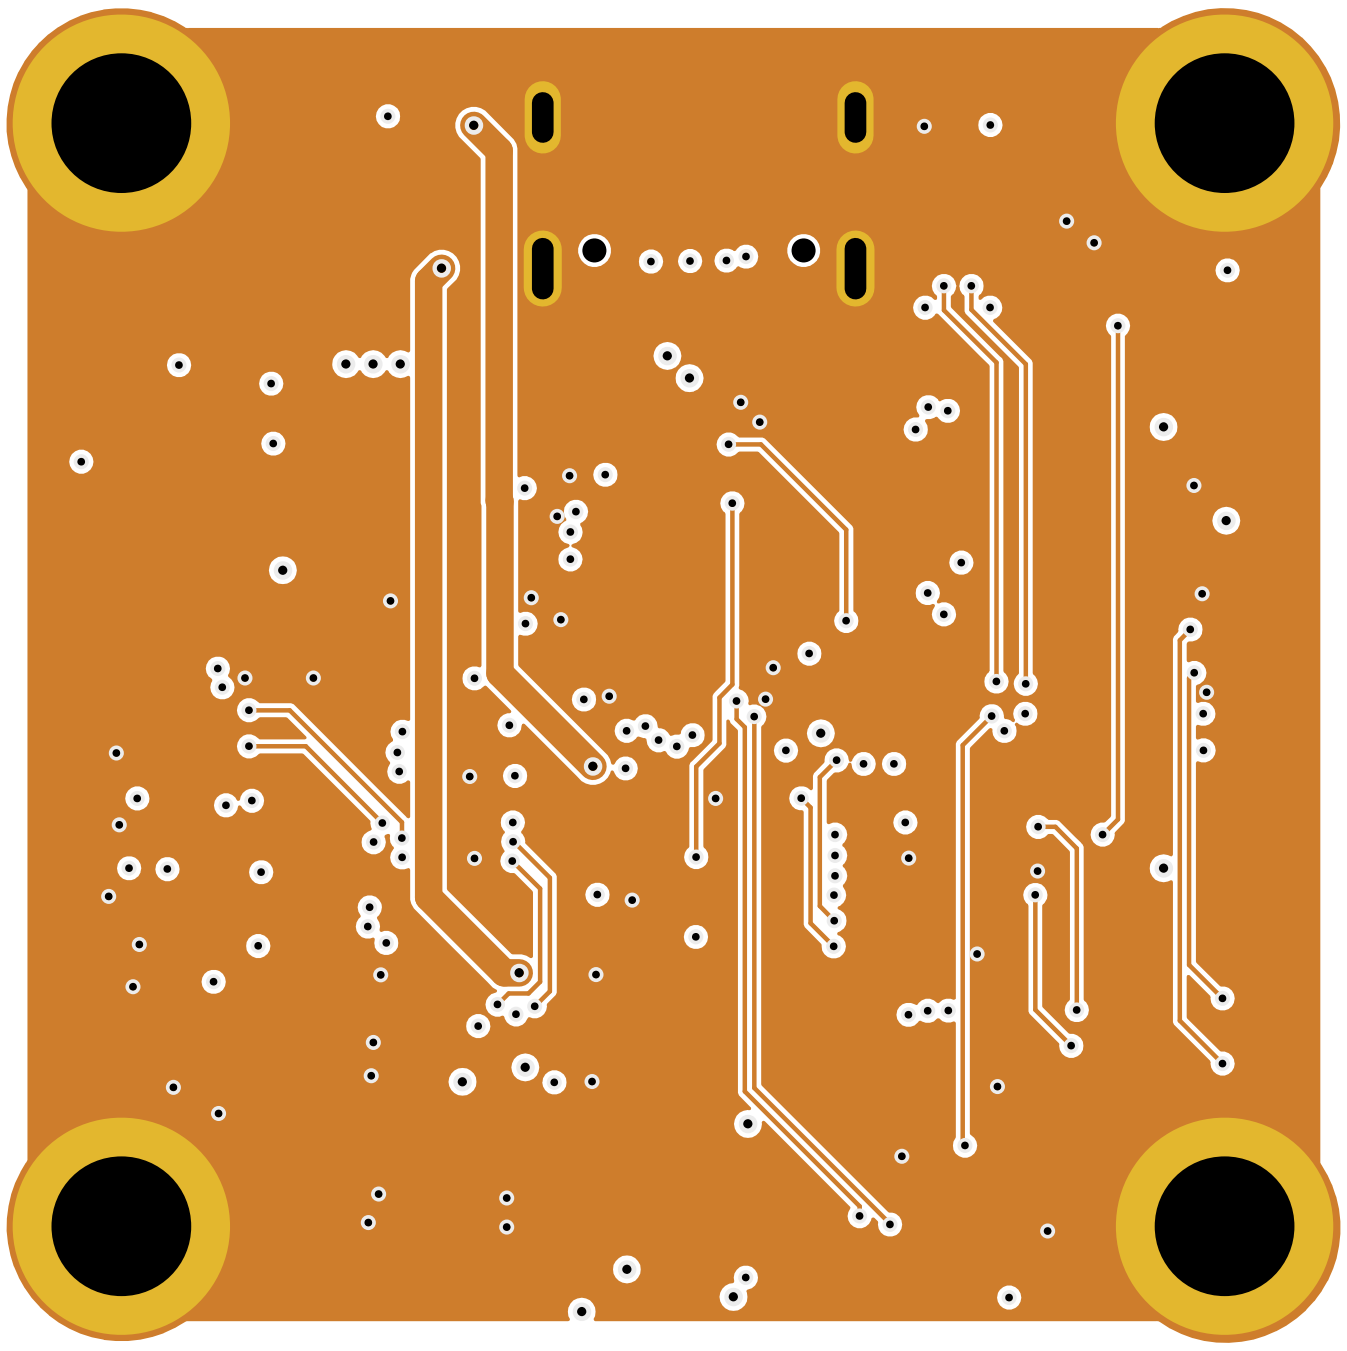
[picture p32: page 3]

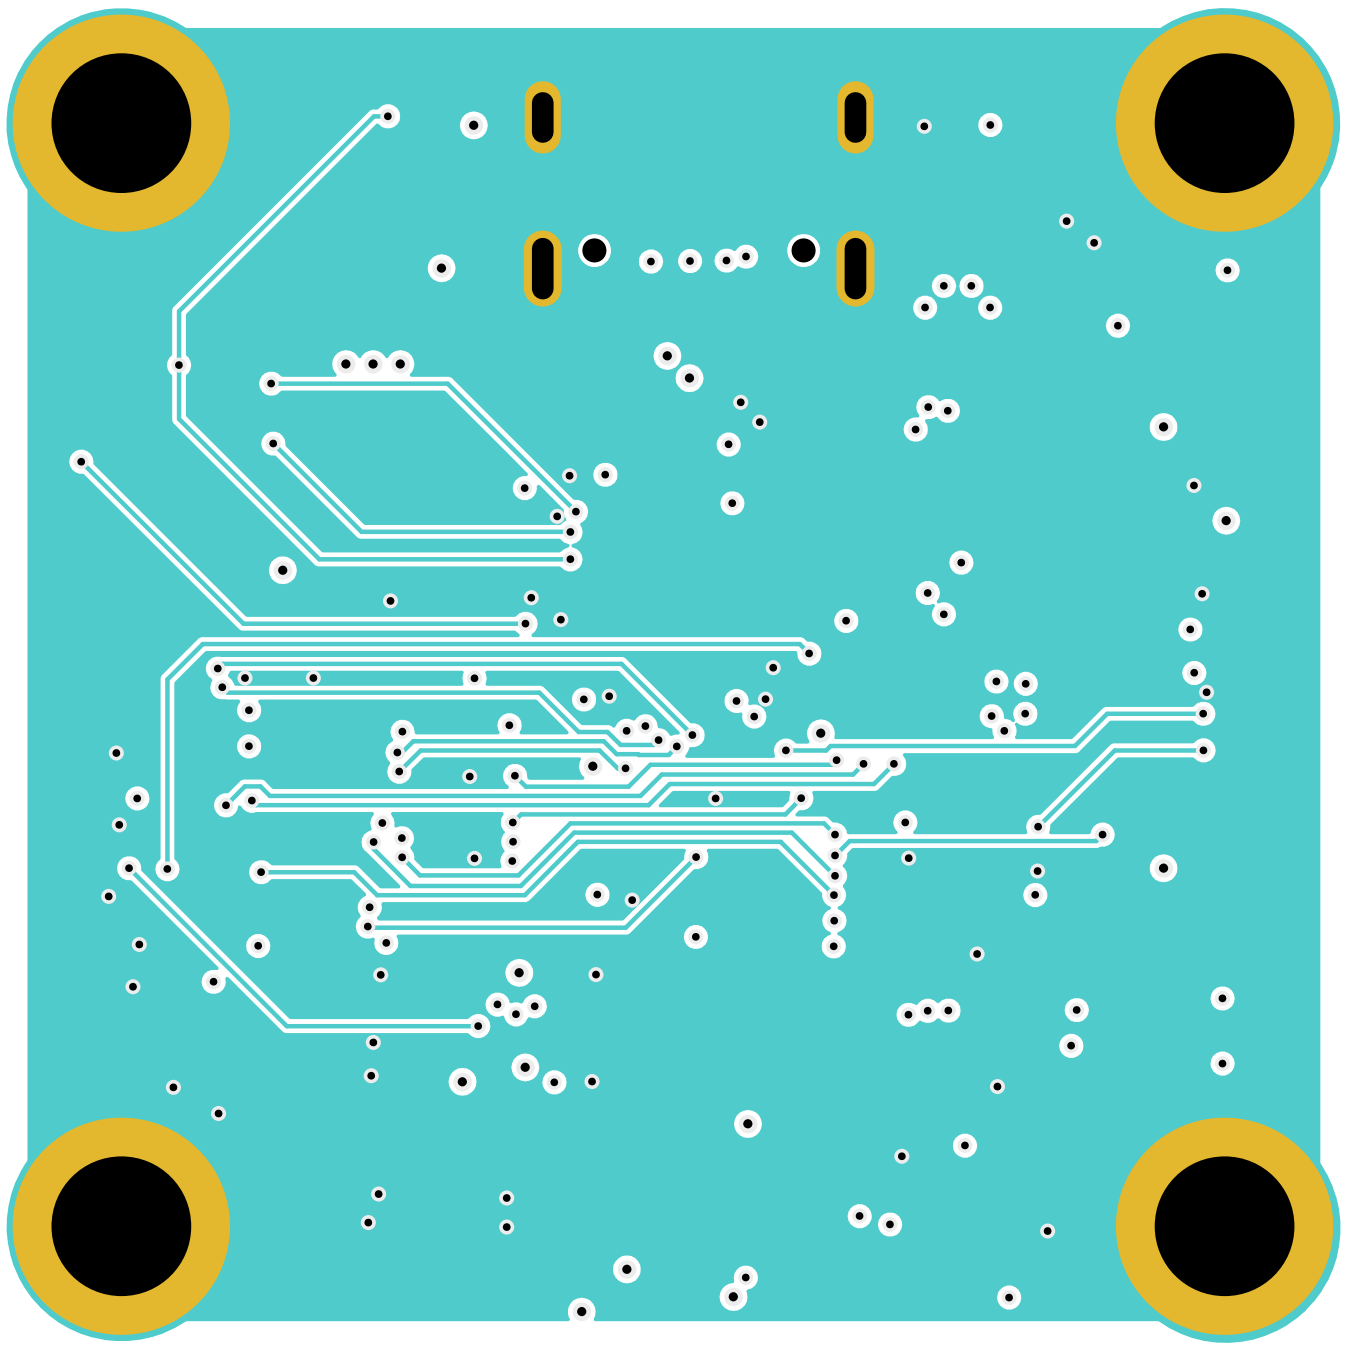
[picture p33: page 4]

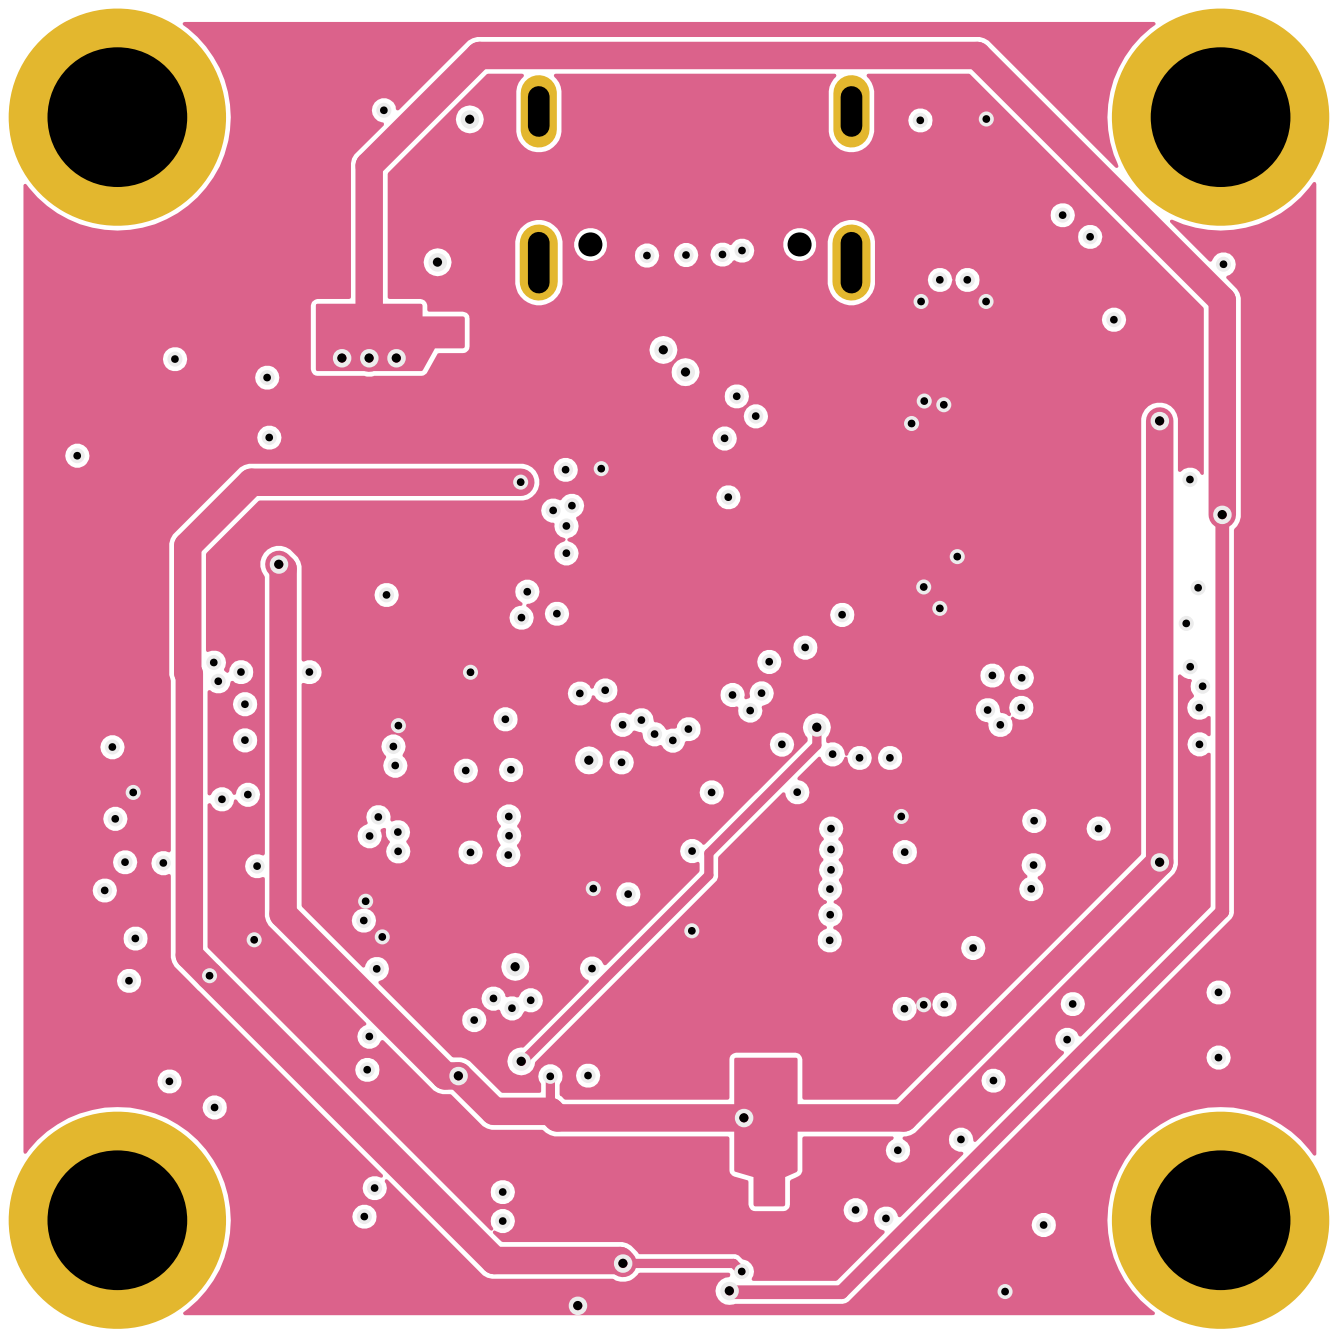
[picture p34: page 5]

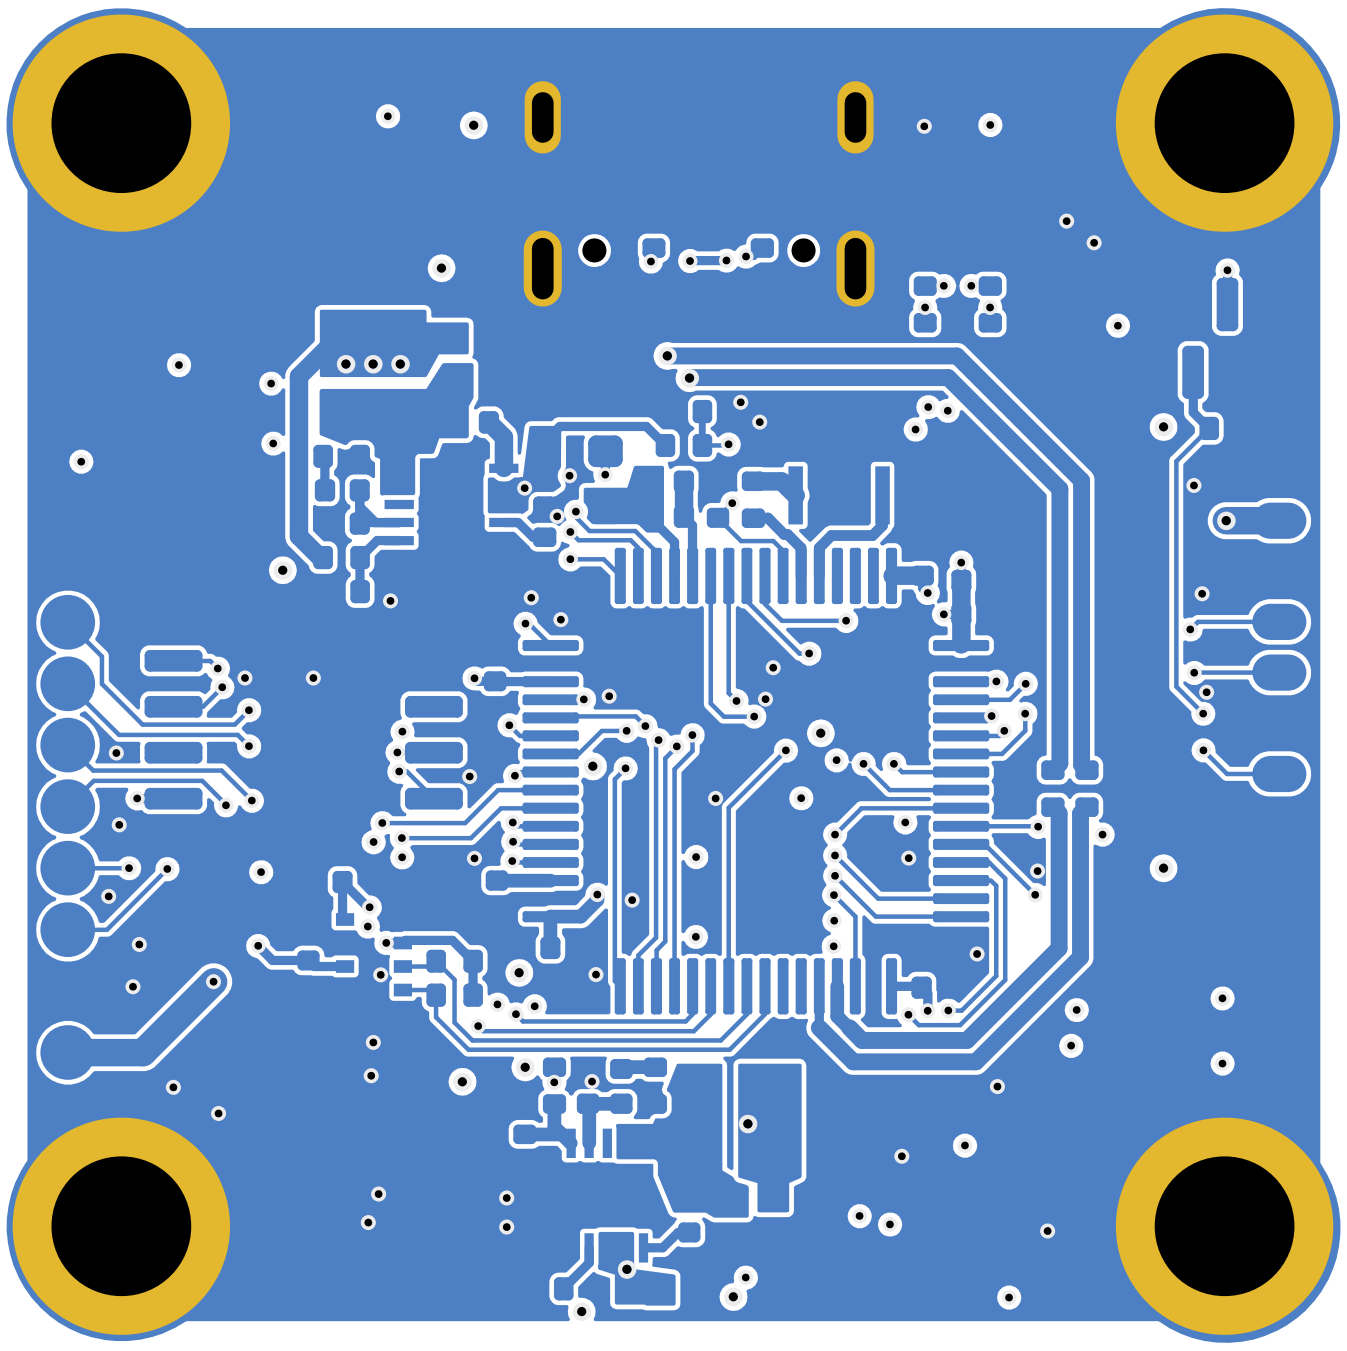
[picture p35: page 6]
