jpwolfe9912/BareDrones-FC-V1/BareDrones-FC-V1.kicad_pcb

## KiCad design BareDrones-FC-V1.kicad_pcb (2024-04-06)

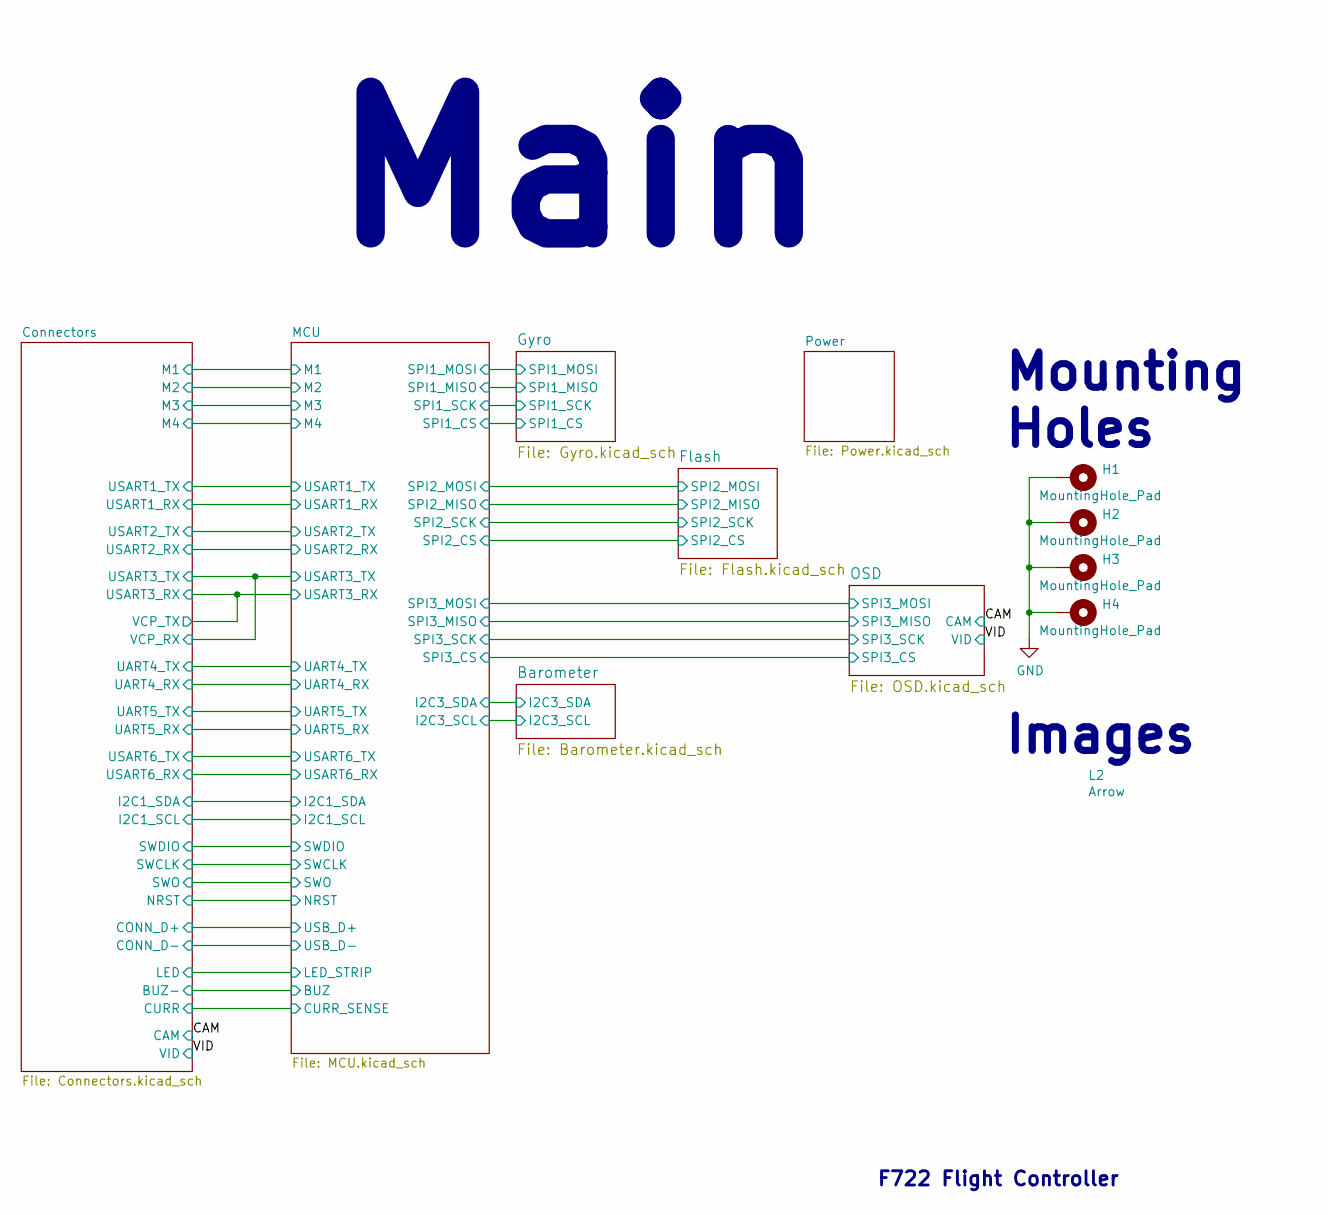
[picture p36: schematic BareDrones-FC-V1.kicad_sch]

Parts:
H1, H2, H3, H4: MountingHole_Pad; M3_Mounting_Hole
L1: EGA
L2: Arrow

Connections:
GND: H1.1, H2.1, H3.1, H4.1; also elsewhere on the board

Notes on the sheet:
F722 Flight Controller
Mounting Holes
Main
Images

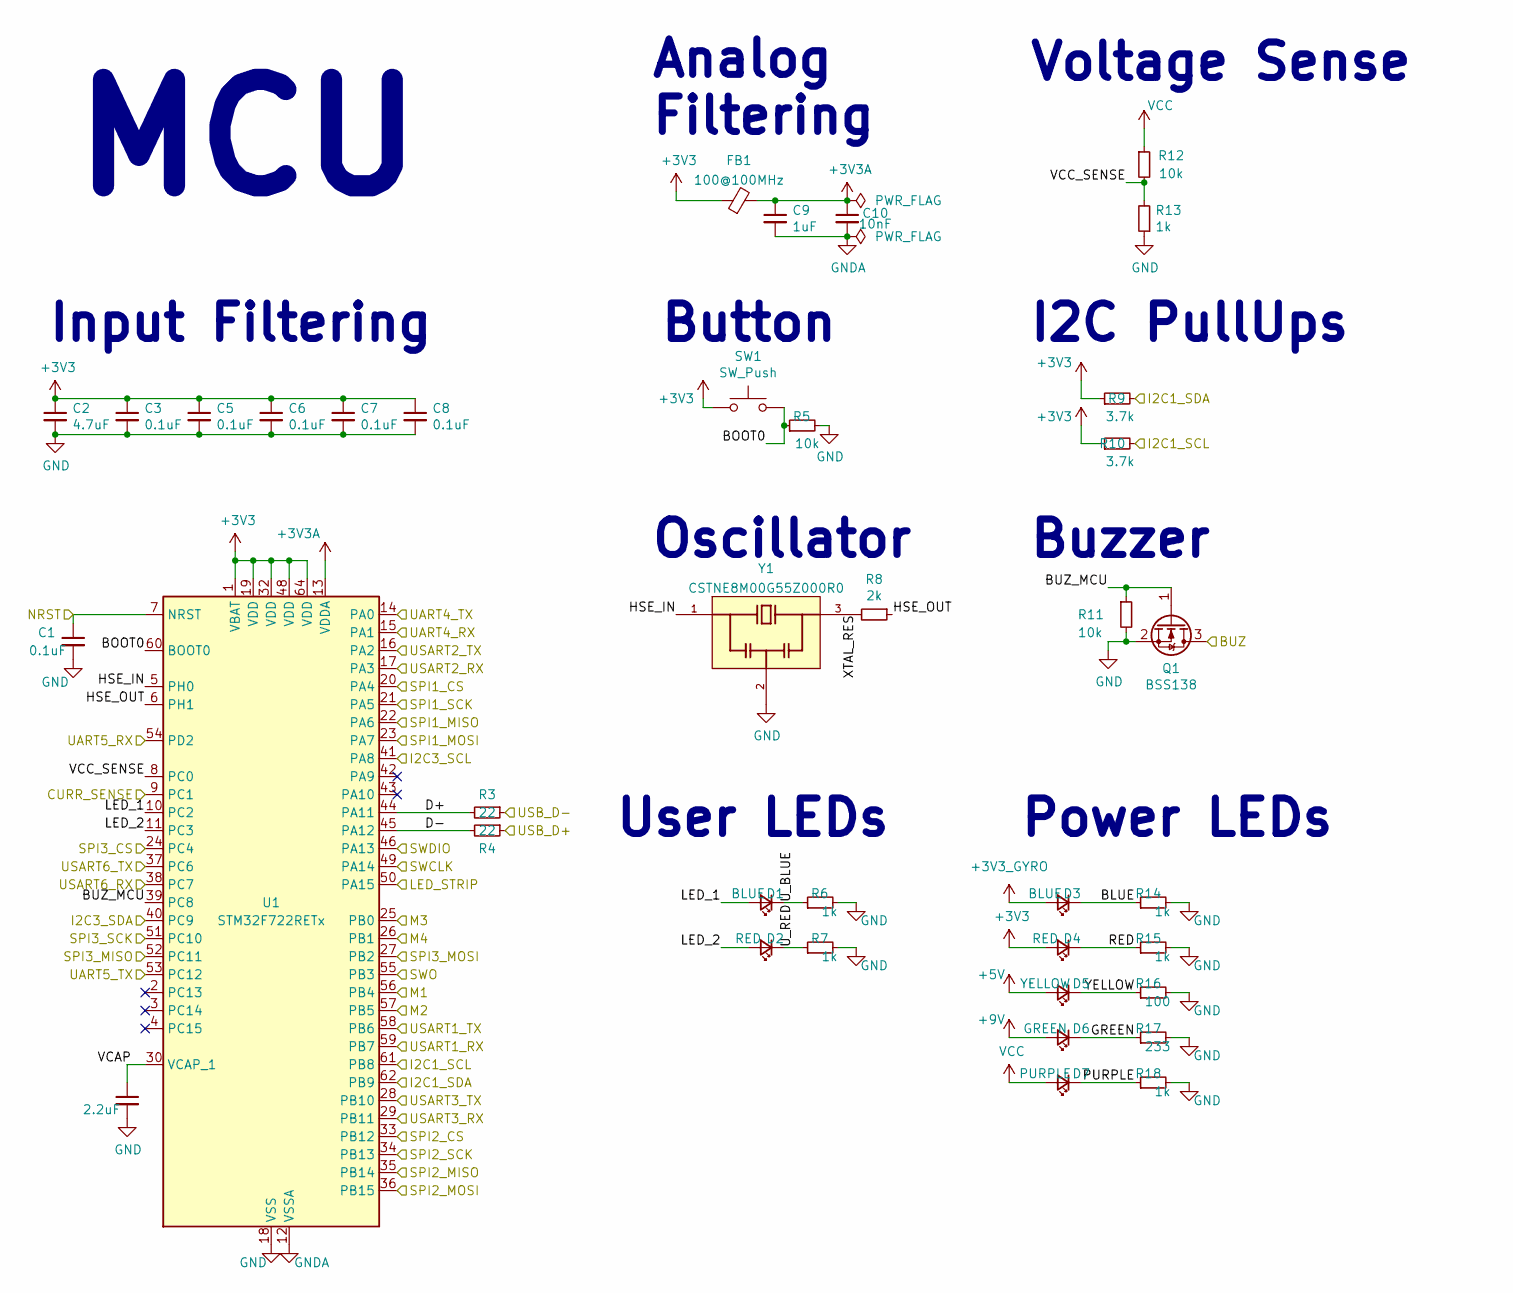
[picture p37: schematic MCU.kicad_sch]

Parts:
C1, C3, C5, C6, C7, C8: 0.1uF; C_0402_1005Metric
C2: 4.7uF; C_0402_1005Metric
C4: 2.2uF; C_0402_1005Metric
C9: 1uF; C_0402_1005Metric
C10: 10nF; C_0402_1005Metric
D1, D3: BLUE; LED_0603_1608Metric
D2, D4: RED; LED_0603_1608Metric
D5: YELLOW; LED_0603_1608Metric
D6: GREEN; LED_0603_1608Metric
D7: PURPLE; LED_0603_1608Metric
FB1: 100@100MHz; L_0603_1608Metric
Q1: BSS138; SOT-23
R3, R4: 22; R_0402_1005Metric
R5, R11, R12: 10k; R_0402_1005Metric
R6, R7, R13, R14, R15, R18: 1k; R_0402_1005Metric
R8: 2k; R_0402_1005Metric
R9, R10: 3.7k; R_0402_1005Metric
R16: 100; R_0402_1005Metric
R17: 233; R_0402_1005Metric
SW1: SW_Push; SW_SPST_B3U-1000P
U1: STM32F722RETx; LQFP-64_10x10mm_P0.5mm
Y1: CSTNE8M00G55Z000R0; OSC_CSTNE8M00G55Z000R0; PARTREV JGC42-8858A

Connections:
+3V3: C2.1, C3.1, C5.1, C6.1, C7.1, C8.1, D4.2 (A), FB1.1, R9.1, R10.1, SW1.1, U1.1 (VBAT), U1.19 (VDD), U1.32 (VDD), U1.48 (VDD), U1.64 (VDD); also elsewhere on the board
+3V3A: C9.1, C10.1, FB1.2, U1.13 (VDDA)
+3V3_GYRO: D3.2 (A); also elsewhere on the board
+5V: D5.2 (A); also elsewhere on the board
+9V: D6.2 (A); also elsewhere on the board
/Barometer/I2C3_SCL: U1.41 (PA8); also elsewhere on the board
/Barometer/I2C3_SDA: U1.40 (PC9); also elsewhere on the board
/Connectors/BUZ-: Q1.3 (D); also elsewhere on the board
/Connectors/CONN_D+: R4.1; also elsewhere on the board
/Connectors/CONN_D-: R3.1; also elsewhere on the board
/Connectors/CURR: U1.9 (PC1); also elsewhere on the board
/Connectors/I2C1_SCL: R10.2, U1.61 (PB8); also elsewhere on the board
/Connectors/I2C1_SDA: R9.2, U1.62 (PB9); also elsewhere on the board
/Connectors/LED: U1.50 (PA15); also elsewhere on the board
/Connectors/M1: U1.56 (PB4); also elsewhere on the board
/Connectors/M2: U1.57 (PB5); also elsewhere on the board
/Connectors/M3: U1.25 (PB0); also elsewhere on the board
/Connectors/M4: U1.26 (PB1); also elsewhere on the board
/Connectors/NRST: C1.1, U1.7 (NRST); also elsewhere on the board
/Connectors/SWCLK: U1.49 (PA14); also elsewhere on the board
/Connectors/SWDIO: U1.46 (PA13); also elsewhere on the board
/Connectors/SWO: U1.55 (PB3); also elsewhere on the board
/Connectors/UART4_RX: U1.15 (PA1); also elsewhere on the board
/Connectors/UART4_TX: U1.14 (PA0); also elsewhere on the board
/Connectors/UART5_RX: U1.54 (PD2); also elsewhere on the board
/Connectors/UART5_TX: U1.53 (PC12); also elsewhere on the board
/Connectors/USART1_RX: U1.59 (PB7); also elsewhere on the board
/Connectors/USART1_TX: U1.58 (PB6); also elsewhere on the board
/Connectors/USART2_RX: U1.17 (PA3); also elsewhere on the board
/Connectors/USART2_TX: U1.16 (PA2); also elsewhere on the board
/Connectors/USART3_RX: U1.29 (PB11); also elsewhere on the board
/Connectors/USART3_TX: U1.28 (PB10); also elsewhere on the board
/Connectors/USART6_RX: U1.38 (PC7); also elsewhere on the board
/Connectors/USART6_TX: U1.37 (PC6); also elsewhere on the board
/Flash/SPI2_CS: U1.33 (PB12); also elsewhere on the board
/Flash/SPI2_MISO: U1.35 (PB14); also elsewhere on the board
/Flash/SPI2_MOSI: U1.36 (PB15); also elsewhere on the board
/Flash/SPI2_SCK: U1.34 (PB13); also elsewhere on the board
/Gyro/SPI1_CS: U1.20 (PA4); also elsewhere on the board
/Gyro/SPI1_MISO: U1.22 (PA6); also elsewhere on the board
/Gyro/SPI1_MOSI: U1.23 (PA7); also elsewhere on the board
/Gyro/SPI1_SCK: U1.21 (PA5); also elsewhere on the board
/MCU/BLUE: D3.1 (K), R14.1
/MCU/BOOT0: R5.1, SW1.2, U1.60 (BOOT0)
/MCU/BUZ_MCU: Q1.1 (G), R11.1, U1.39 (PC8)
/MCU/D+: R3.2, U1.44 (PA11)
/MCU/D-: R4.2, U1.45 (PA12)
/MCU/GREEN: D6.1 (K), R17.1
/MCU/HSE_IN: U1.5 (PH0), Y1.1
/MCU/HSE_OUT: R8.1, U1.6 (PH1)
/MCU/LED_1: D1.2 (A), U1.10 (PC2)
/MCU/LED_2: D2.2 (A), U1.11 (PC3)
/MCU/PURPLE: D7.1 (K), R18.1
/MCU/RED: D4.1 (K), R15.1
/MCU/SPI3_CS: U1.24 (PC4); also elsewhere on the board
/MCU/SPI3_MISO: U1.52 (PC11); also elsewhere on the board
/MCU/SPI3_MOSI: U1.27 (PB2); also elsewhere on the board
/MCU/SPI3_SCK: U1.51 (PC10); also elsewhere on the board
/MCU/U_BLUE: D1.1 (K), R6.1
/MCU/U_RED: D2.1 (K), R7.1
/MCU/VCAP: C4.1, U1.30 (VCAP_1)
/MCU/VCC_SENSE: R12.2, R13.2, U1.8 (PC0)
/MCU/XTAL_RES: R8.2, Y1.3
/MCU/YELLOW: D5.1 (K), R16.1
GND: C1.2, C2.2, C3.2, C4.2, C5.2, C6.2, C7.2, C8.2, Q1.2 (S), R5.2, R6.2, R7.2, R11.2, R13.1, R14.2, R15.2, R16.2, R17.2, R18.2, U1.18 (VSS), U1.31 (VSS), U1.47 (VSS), U1.63 (VSS), Y1.2; also elsewhere on the board
GNDA: C9.2, C10.2, U1.12 (VSSA)
VCC: D7.2 (A), R12.1; also elsewhere on the board

Notes on the sheet:
MCU
User LEDs
Buzzer
Analog Filtering
Input Filtering
Oscillator
I2C PullUps
Button
Voltage Sense
Power LEDs

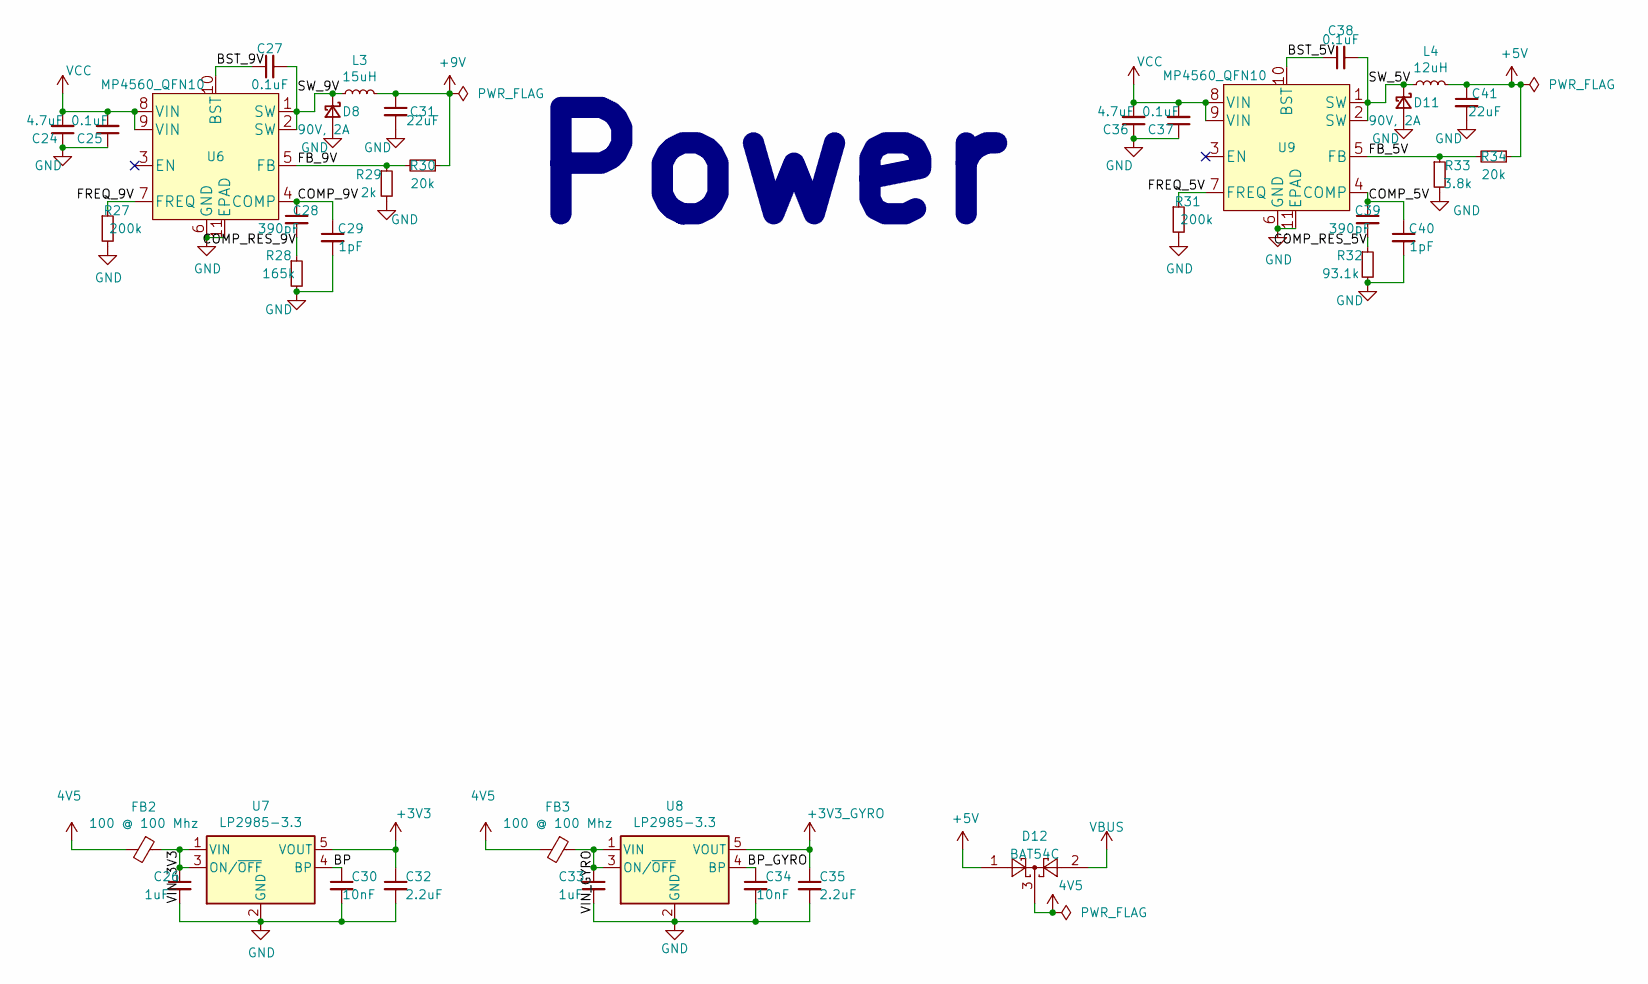
[picture p38: schematic Power.kicad_sch]

Parts:
C24, C36: 4.7uF; C_0402_1005Metric
C25, C27, C37, C38: 0.1uF; C_0402_1005Metric
C26, C33: 1uF; C_0402_1005Metric
C28, C39: 390pF; C_0402_1005Metric
C29, C40: 1pF; C_0402_1005Metric
C30, C34: 10nF; C_0402_1005Metric
C31, C41: 22uF; C_0402_1005Metric
C32, C35: 2.2uF; C_0402_1005Metric
D8, D11: 90V, 2A; D_SOD-523
D12: BAT54C; SOT-23
FB2, FB3: 100 @ 100 Mhz; L_0603_1608Metric
L3: 15uH; SRN3015-4R7M
L4: 12uH; SRN3015-4R7M
R27, R31: 200k; R_0402_1005Metric
R28: 165k; R_0402_1005Metric
R29: 2k; R_0402_1005Metric
R30, R34: 20k; R_0402_1005Metric
R32: 93.1k; R_0402_1005Metric
R33: 3.8k; R_0402_1005Metric
U6, U9: MP4560_QFN10; MP4560DQ
U7, U8: LP2985-3.3; SOT-23-5

Connections:
4V5: D12.3, FB2.2, FB3.2; also elsewhere on the board
+3V3: C32.1, U7.5 (VOUT); also elsewhere on the board
+3V3_GYRO: C35.1, U8.5 (VOUT); also elsewhere on the board
+5V: C41.1, D12.1, L4.2, R34.1; also elsewhere on the board
+9V: C31.1, L3.2, R30.1; also elsewhere on the board
/Power/BP: C30.1, U7.4 (BP)
/Power/BP_GYRO: C34.1, U8.4 (BP)
/Power/BST_5V: C38.1, U9.10 (BST)
/Power/BST_9V: C27.1, U6.10 (BST)
/Power/COMP_5V: C39.1, C40.1, U9.4 (COMP)
/Power/COMP_9V: C28.1, C29.1, U6.4 (COMP)
/Power/COMP_RES_5V: C39.2, R32.1
/Power/COMP_RES_9V: C28.2, R28.1
/Power/FB_5V: R33.1, R34.2, U9.5 (FB)
/Power/FB_9V: R29.1, R30.2, U6.5 (FB)
/Power/FREQ_5V: R31.1, U9.7 (FREQ)
/Power/FREQ_9V: R27.1, U6.7 (FREQ)
/Power/SW_5V: C38.2, D11.1 (K), L4.1, U9.1 (SW), U9.2 (SW)
/Power/SW_9V: C27.2, D8.1 (K), L3.1, U6.1 (SW), U6.2 (SW)
/Power/VIN_3V3: C26.1, FB2.1, U7.1 (VIN), U7.3 (ON/~OFF)
/Power/VIN_GYRO: C33.1, FB3.1, U8.1 (VIN), U8.3 (ON/~OFF)
GND: C24.1, C25.1, C26.2, C29.2, C30.2, C31.2, C32.2, C33.2, C34.2, C35.2, C36.1, C37.1, C40.2, C41.2, D8.2 (A), D11.2 (A), R27.2, R28.2, R29.2, R31.2, R32.2, R33.2, U6.6 (GND), U6.11 (EPAD), U7.2 (GND), U8.2 (GND), U9.6 (GND), U9.11 (EPAD); also elsewhere on the board
VBUS: D12.2; also elsewhere on the board
VCC: C24.2, C25.2, C36.2, C37.2, U6.8 (VIN), U6.9 (VIN), U9.8 (VIN), U9.9 (VIN); also elsewhere on the board

Notes on the sheet:
Power

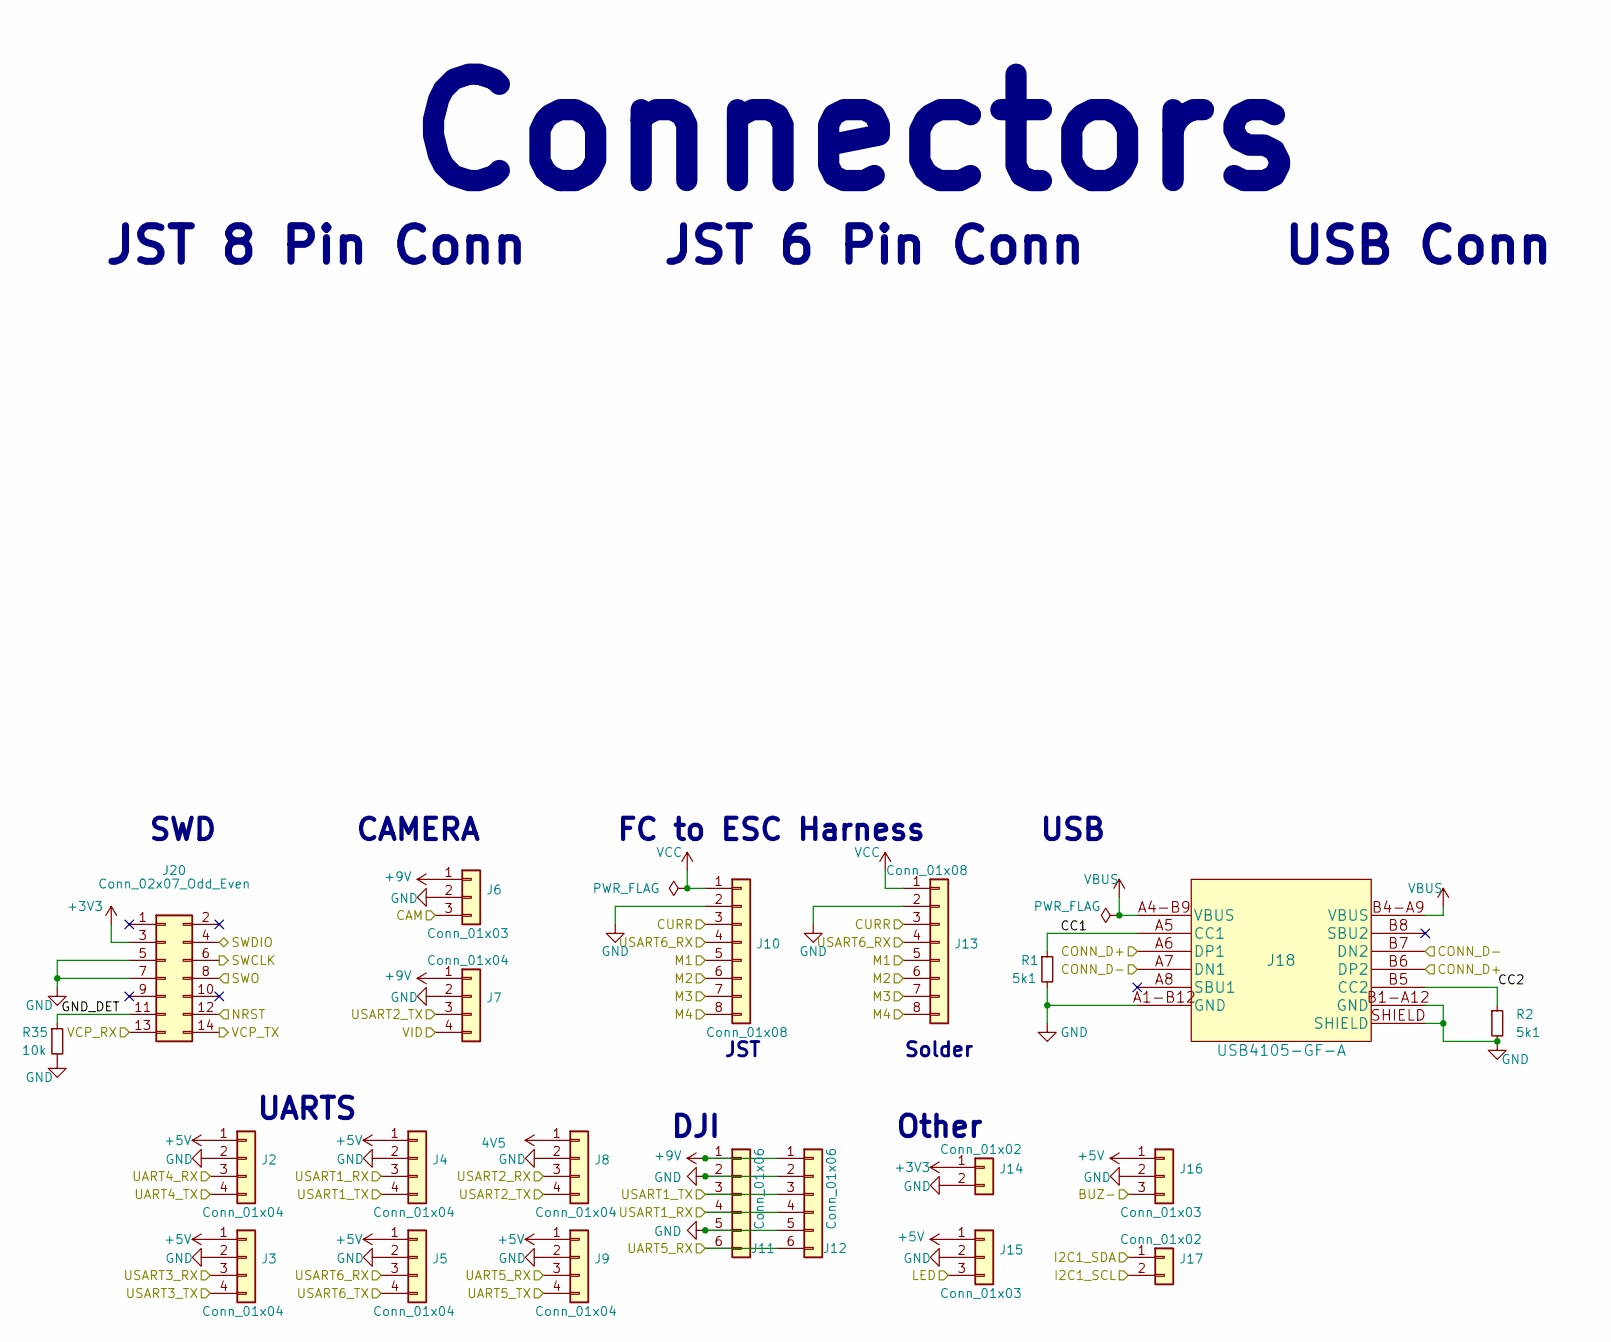
[picture p39: schematic Connectors.kicad_sch]

Parts:
J2, J3, J4, J5, J7, J8, J9: Conn_01x04; Conn_1x4_SMT
J6, J15, J16: Conn_01x03; Conn_1x3_SMT
J10: Conn_01x08; JST_SH_SM08B-SRSS-TB_1x08-1MP_P1.00mm_Horizontal
J11: Conn_01x06; JST_SH_SM06B-SRSS-TB_1x06-1MP_P1.00mm_Horizontal
J12: Conn_01x06; Conn_DJI
J13: Conn_01x08; Conn_8Edge_SMT
J14, J17: Conn_01x02; Conn_1x2_SMT
J18: USB4105-GF-A; GCT_USB4105-GF-A
J20: Conn_02x07_Odd_Even; PinHeader_2x07_P1.27mm_Vertical_SMD
R1, R2: 5k1; R_0402_1005Metric
R35: 10k; R_0402_1005Metric

Connections:
4V5: J8.1; also elsewhere on the board
+3V3: J14.1, J20.3; also elsewhere on the board
+5V: J2.1, J3.1, J4.1, J5.1, J9.1, J15.1, J16.1; also elsewhere on the board
+9V: J6.1, J7.1, J11.1, J12.1; also elsewhere on the board
/CAM: J6.3; also elsewhere on the board
/Connectors/BUZ-: J16.3; also elsewhere on the board
/Connectors/CC1: J18.A5 (CC1), R1.1
/Connectors/CC2: J18.B5 (CC2), R2.1
/Connectors/CONN_D+: J18.A6 (DP1), J18.B6 (DP2); also elsewhere on the board
/Connectors/CONN_D-: J18.A7 (DN1), J18.B7 (DN2); also elsewhere on the board
/Connectors/CURR: J10.3, J13.3; also elsewhere on the board
/Connectors/GND_DET: J20.11, R35.1
/Connectors/I2C1_SCL: J17.2; also elsewhere on the board
/Connectors/I2C1_SDA: J17.1; also elsewhere on the board
/Connectors/LED: J15.3; also elsewhere on the board
/Connectors/M1: J10.5, J13.5; also elsewhere on the board
/Connectors/M2: J10.6, J13.6; also elsewhere on the board
/Connectors/M3: J10.7, J13.7; also elsewhere on the board
/Connectors/M4: J10.8, J13.8; also elsewhere on the board
/Connectors/NRST: J20.12; also elsewhere on the board
/Connectors/SWCLK: J20.6; also elsewhere on the board
/Connectors/SWDIO: J20.4; also elsewhere on the board
/Connectors/SWO: J20.8; also elsewhere on the board
/Connectors/UART4_RX: J2.3; also elsewhere on the board
/Connectors/UART4_TX: J2.4; also elsewhere on the board
/Connectors/UART5_RX: J9.3, J11.6, J12.6; also elsewhere on the board
/Connectors/UART5_TX: J9.4; also elsewhere on the board
/Connectors/USART1_RX: J4.3, J11.4, J12.4; also elsewhere on the board
/Connectors/USART1_TX: J4.4, J11.3, J12.3; also elsewhere on the board
/Connectors/USART2_RX: J8.3; also elsewhere on the board
/Connectors/USART2_TX: J7.3, J8.4; also elsewhere on the board
/Connectors/USART3_RX: J3.3, J20.14; also elsewhere on the board
/Connectors/USART3_TX: J3.4, J20.13; also elsewhere on the board
/Connectors/USART6_RX: J5.3, J10.4, J13.4; also elsewhere on the board
/Connectors/USART6_TX: J5.4; also elsewhere on the board
/VID: J7.4; also elsewhere on the board
GND: J2.2, J3.2, J4.2, J5.2, J6.2, J7.2, J8.2, J9.2, J10.2, J11.2, J11.5, J12.2, J12.5, J13.2, J14.2, J15.2, J16.2, J18.A1-B12 (GND), J18.B1-A12 (GND), J18.SHIELD, J20.5, J20.7, R1.2, R2.2, R35.2; also elsewhere on the board
VBUS: J18.A4-B9 (VBUS), J18.B4-A9 (VBUS); also elsewhere on the board
VCC: J10.1, J13.1; also elsewhere on the board

Notes on the sheet:
JST 6 Pin Conn
Solder
JST
Connectors
CAMERA
Other
JST 8 Pin Conn
DJI
USB Conn
USB
UARTS
FC to ESC Harness
SWD

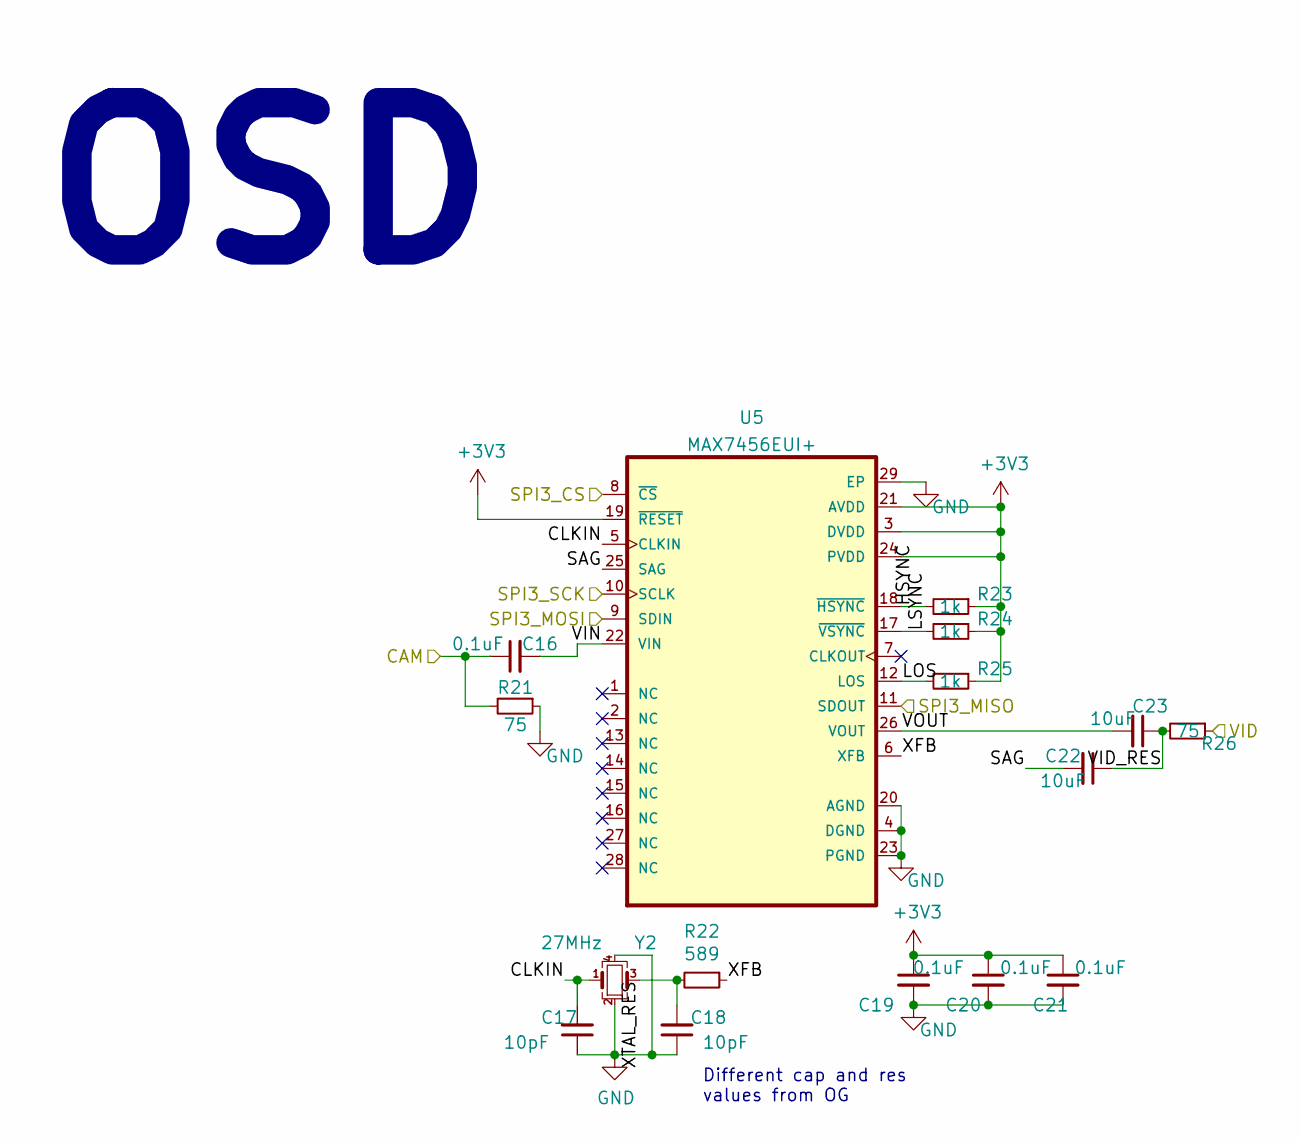
[picture p40: schematic OSD.kicad_sch]

Parts:
C16, C19, C20, C21: 0.1uF; C_0402_1005Metric
C17, C18: 10pF; C_0402_1005Metric
C22, C23: 10uF; C_0402_1005Metric
R21, R26: 75; R_0402_1005Metric
R22: 589; R_0402_1005Metric
R23, R24, R25: 1k; R_0402_1005Metric
U5: MAX7456EUI+; MAX7456
Y2: 27MHz; Oscillator_SMD_Abracon_ASE-4Pin_3.2x2.5mm

Connections:
+3V3: C19.1, C20.1, C21.1, R23.1, R24.1, R25.1, U5.3 (DVDD), U5.19 (~RESET), U5.21 (AVDD), U5.24 (PVDD); also elsewhere on the board
/CAM: C16.1, R21.2; also elsewhere on the board
/MCU/SPI3_CS: U5.8 (~CS); also elsewhere on the board
/MCU/SPI3_MISO: U5.11 (SDOUT); also elsewhere on the board
/MCU/SPI3_MOSI: U5.9 (SDIN); also elsewhere on the board
/MCU/SPI3_SCK: U5.10 (SCLK); also elsewhere on the board
/OSD/CLKIN: C17.2, U5.5 (CLKIN), Y2.1
/OSD/HSYNC: R23.2, U5.18 (~HSYNC)
/OSD/LOS: R25.2, U5.12 (LOS)
/OSD/LSYNC: R24.2, U5.17 (~VSYNC)
/OSD/SAG: C22.2, U5.25 (SAG)
/OSD/VID_RES: C22.1, C23.1, R26.2
/OSD/VIN: C16.2, U5.22 (VIN)
/OSD/VOUT: C23.2, U5.26 (VOUT)
/OSD/XFB: R22.1, U5.6 (XFB)
/OSD/XTAL_RES: C18.2, R22.2, Y2.3
/VID: R26.1; also elsewhere on the board
GND: C17.1, C18.1, C19.2, C20.2, C21.2, R21.1, U5.4 (DGND), U5.20 (AGND), U5.23 (PGND), U5.29 (EP), Y2.2, Y2.4; also elsewhere on the board

Notes on the sheet:
Different cap and res values from OG
OSD

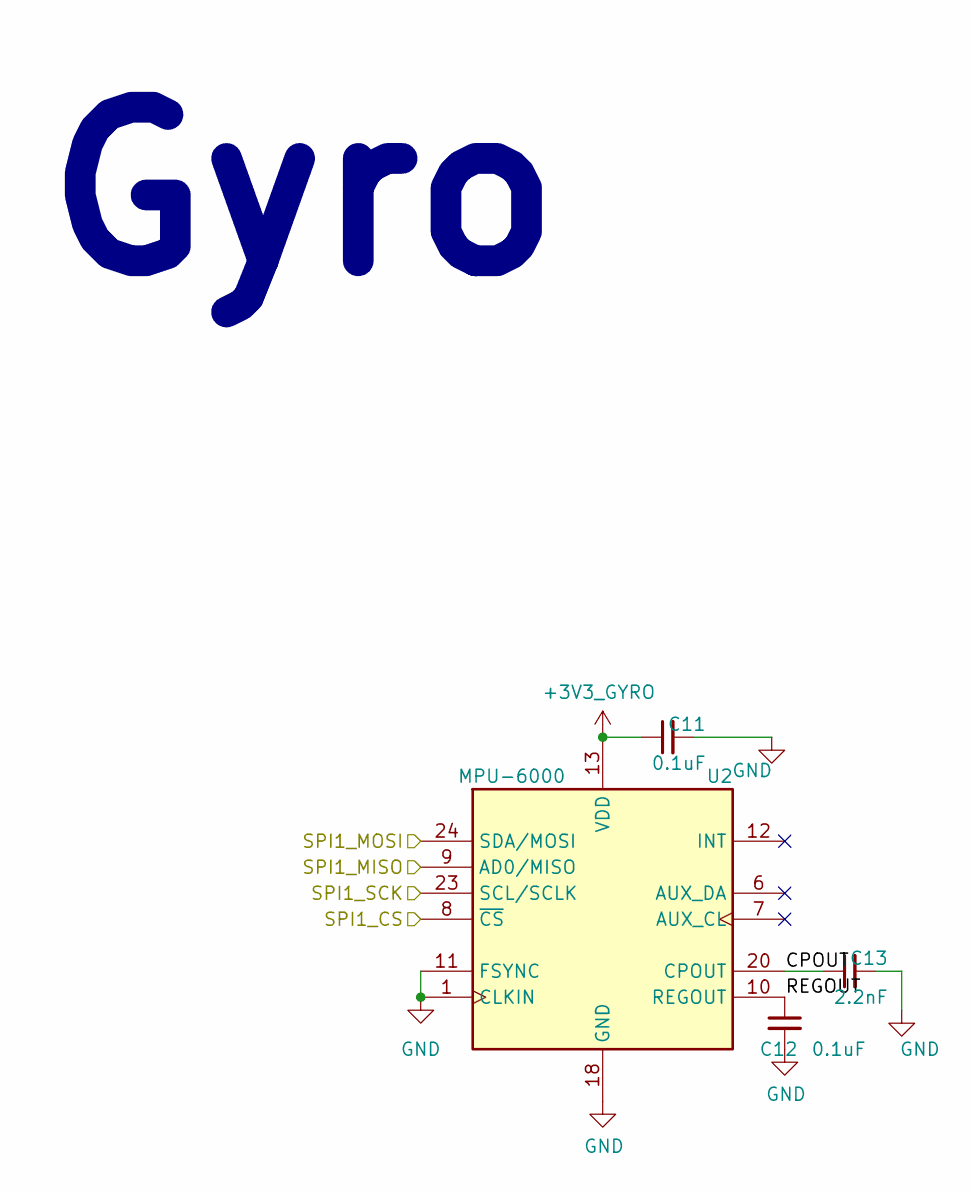
[picture p41: schematic Gyro.kicad_sch]

Parts:
C11, C12: 0.1uF; C_0402_1005Metric
C13: 2.2nF; C_0402_1005Metric
U2: MPU-6000; InvenSense_QFN-24_4x4mm_P0.5mm

Connections:
+3V3_GYRO: C11.1, U2.13 (VDD); also elsewhere on the board
/Gyro/CPOUT: C13.1, U2.20 (CPOUT)
/Gyro/REGOUT: C12.1, U2.10 (REGOUT)
/Gyro/SPI1_CS: U2.8 (~CS); also elsewhere on the board
/Gyro/SPI1_MISO: U2.9 (AD0/MISO); also elsewhere on the board
/Gyro/SPI1_MOSI: U2.24 (SDA/MOSI); also elsewhere on the board
/Gyro/SPI1_SCK: U2.23 (SCL/SCLK); also elsewhere on the board
GND: C11.2, C12.2, C13.2, U2.1 (CLKIN), U2.11 (FSYNC), U2.18 (GND); also elsewhere on the board

Notes on the sheet:
Gyro

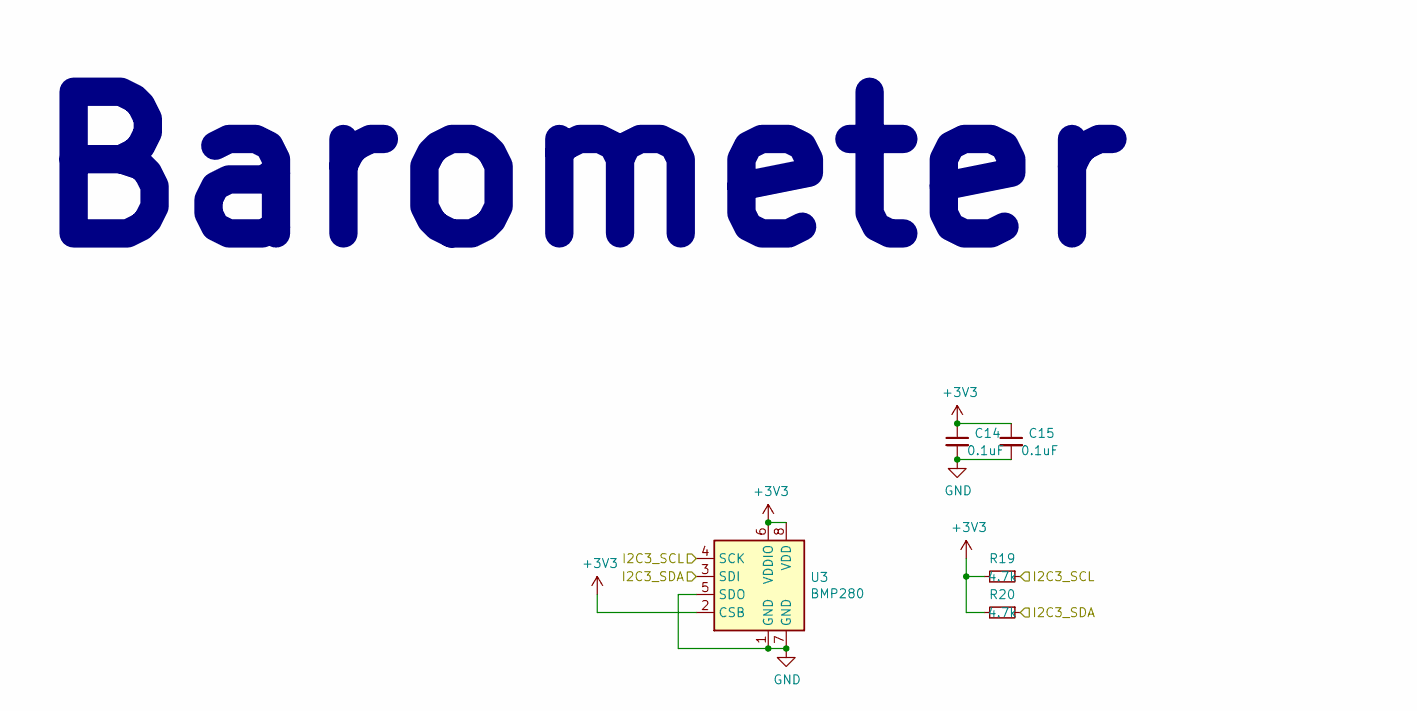
[picture p42: schematic Barometer.kicad_sch]

Parts:
C14, C15: 0.1uF; C_0402_1005Metric
R19, R20: 4.7k; R_0402_1005Metric
U3: BMP280; Bosch_LGA-8_2x2.5mm_P0.65mm_ClockwisePinNumbering

Connections:
+3V3: C14.1, C15.1, R19.2, R20.2, U3.2 (CSB), U3.6 (VDDIO), U3.8 (VDD); also elsewhere on the board
/Barometer/I2C3_SCL: R19.1, U3.4 (SCK); also elsewhere on the board
/Barometer/I2C3_SDA: R20.1, U3.3 (SDI); also elsewhere on the board
GND: C14.2, C15.2, U3.1 (GND), U3.5 (SDO), U3.7 (GND); also elsewhere on the board

Notes on the sheet:
Barometer

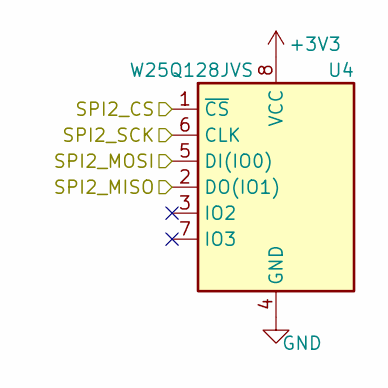
[picture p43: schematic Flash.kicad_sch]

Parts:
U4: W25Q128JVS; SOIC-8_5.23x5.23mm_P1.27mm

Connections:
+3V3: U4.8 (VCC); also elsewhere on the board
/Flash/SPI2_CS: U4.1 (~CS); also elsewhere on the board
/Flash/SPI2_MISO: U4.2 (DO(IO1)); also elsewhere on the board
/Flash/SPI2_MOSI: U4.5 (DI(IO0)); also elsewhere on the board
/Flash/SPI2_SCK: U4.6 (CLK); also elsewhere on the board
GND: U4.4 (GND); also elsewhere on the board

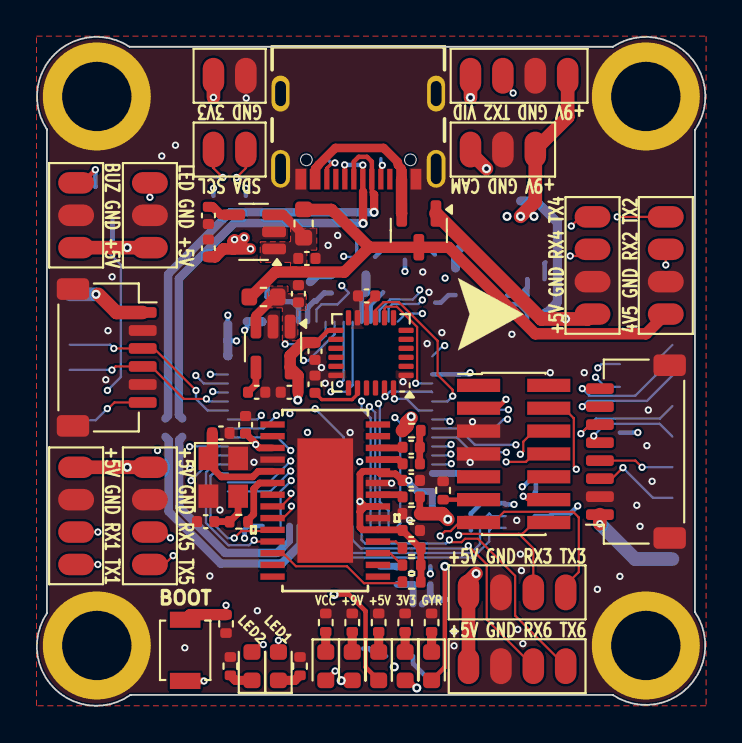
[picture p44: board BareDrones-FC-V1.kicad_pcb from above]

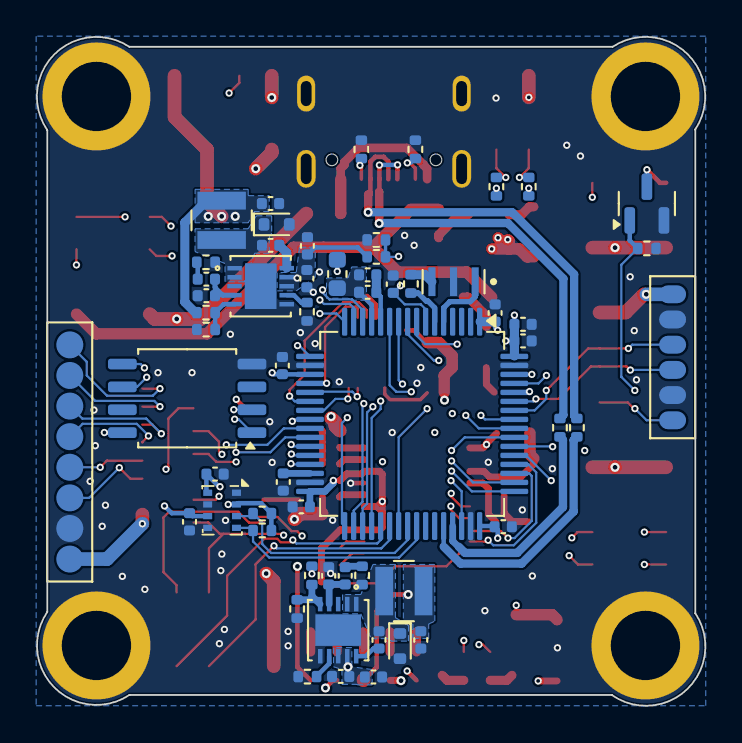
[picture p45: board BareDrones-FC-V1.kicad_pcb from below]

Board: 6 copper layers, 37.1 x 37.2 mm, 127 parts (58 on the bottom side), 102 nets.
