jpwolfe9912/BareDrones-FC-V1/(commit log)

2024-04-05 Finished power and signal routing.
    [BareDrones-FC-V1.kicad_sch, Barometer.kicad_sch, Connectors.kicad_sch, Flash.kicad_sch, Gyro.kicad_sch, MCU.kicad_sch, OSD.kicad_sch, Power.kicad_sch]
2024-04-05 Finished connections
    [BareDrones-FC-V1.kicad_pcb, bom.csv, designators.csv, positions.csv]
2024-04-06 Edited pics and reorganized
    [BareDrones-FC-V1.kicad_pcb, bom.csv, designators.csv, positions.csv]
2024-04-06 Added gerber PDFs
